kcuzner/rt-soldering-iron/ref/oled-drawing.png

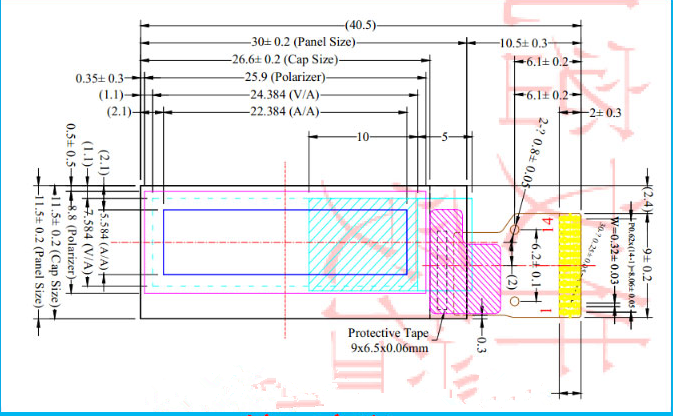
ref/oled-drawing.png
