kcuzner/rt-soldering-iron/ref/oled-pinout.png

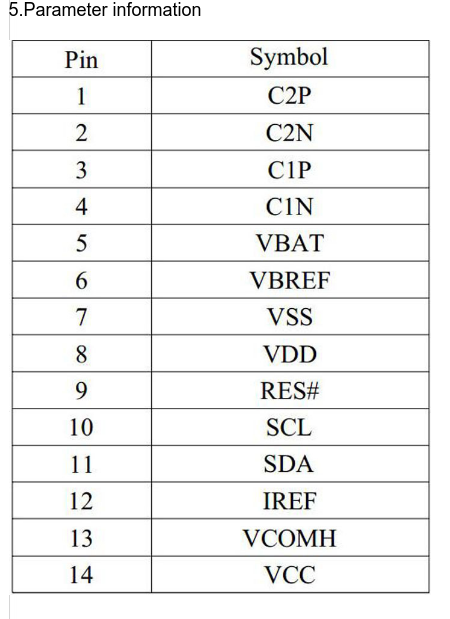
ref/oled-pinout.png
