kcuzner/rt-soldering-iron/ltspice/OVP Latch.asc

C1: cap; 1p
M1: nmos; 2N7002
Q1: pnp; 2N3906
R1: res; 22.6K
R2: res; 10K
R3: res; 10K
R4: res; 1K
R5: res; 10K
R6: res; 10K
U1: TL431
V1: voltage; PULSE(0 3.65 3m 1m 1n 10m 20m)
V2: voltage; PULSE(0 12 0 {DLY})
V3: voltage; 12
Named nets: 0, VLatch
.tran 40m
.step param DLY 0 1m 0.1m
