kcuzner/rt-soldering-iron/kicad/rt-soldering-iron.kicad_pcb

## KiCad design kicad/rt-soldering-iron.kicad_pcb (2017-11-07)

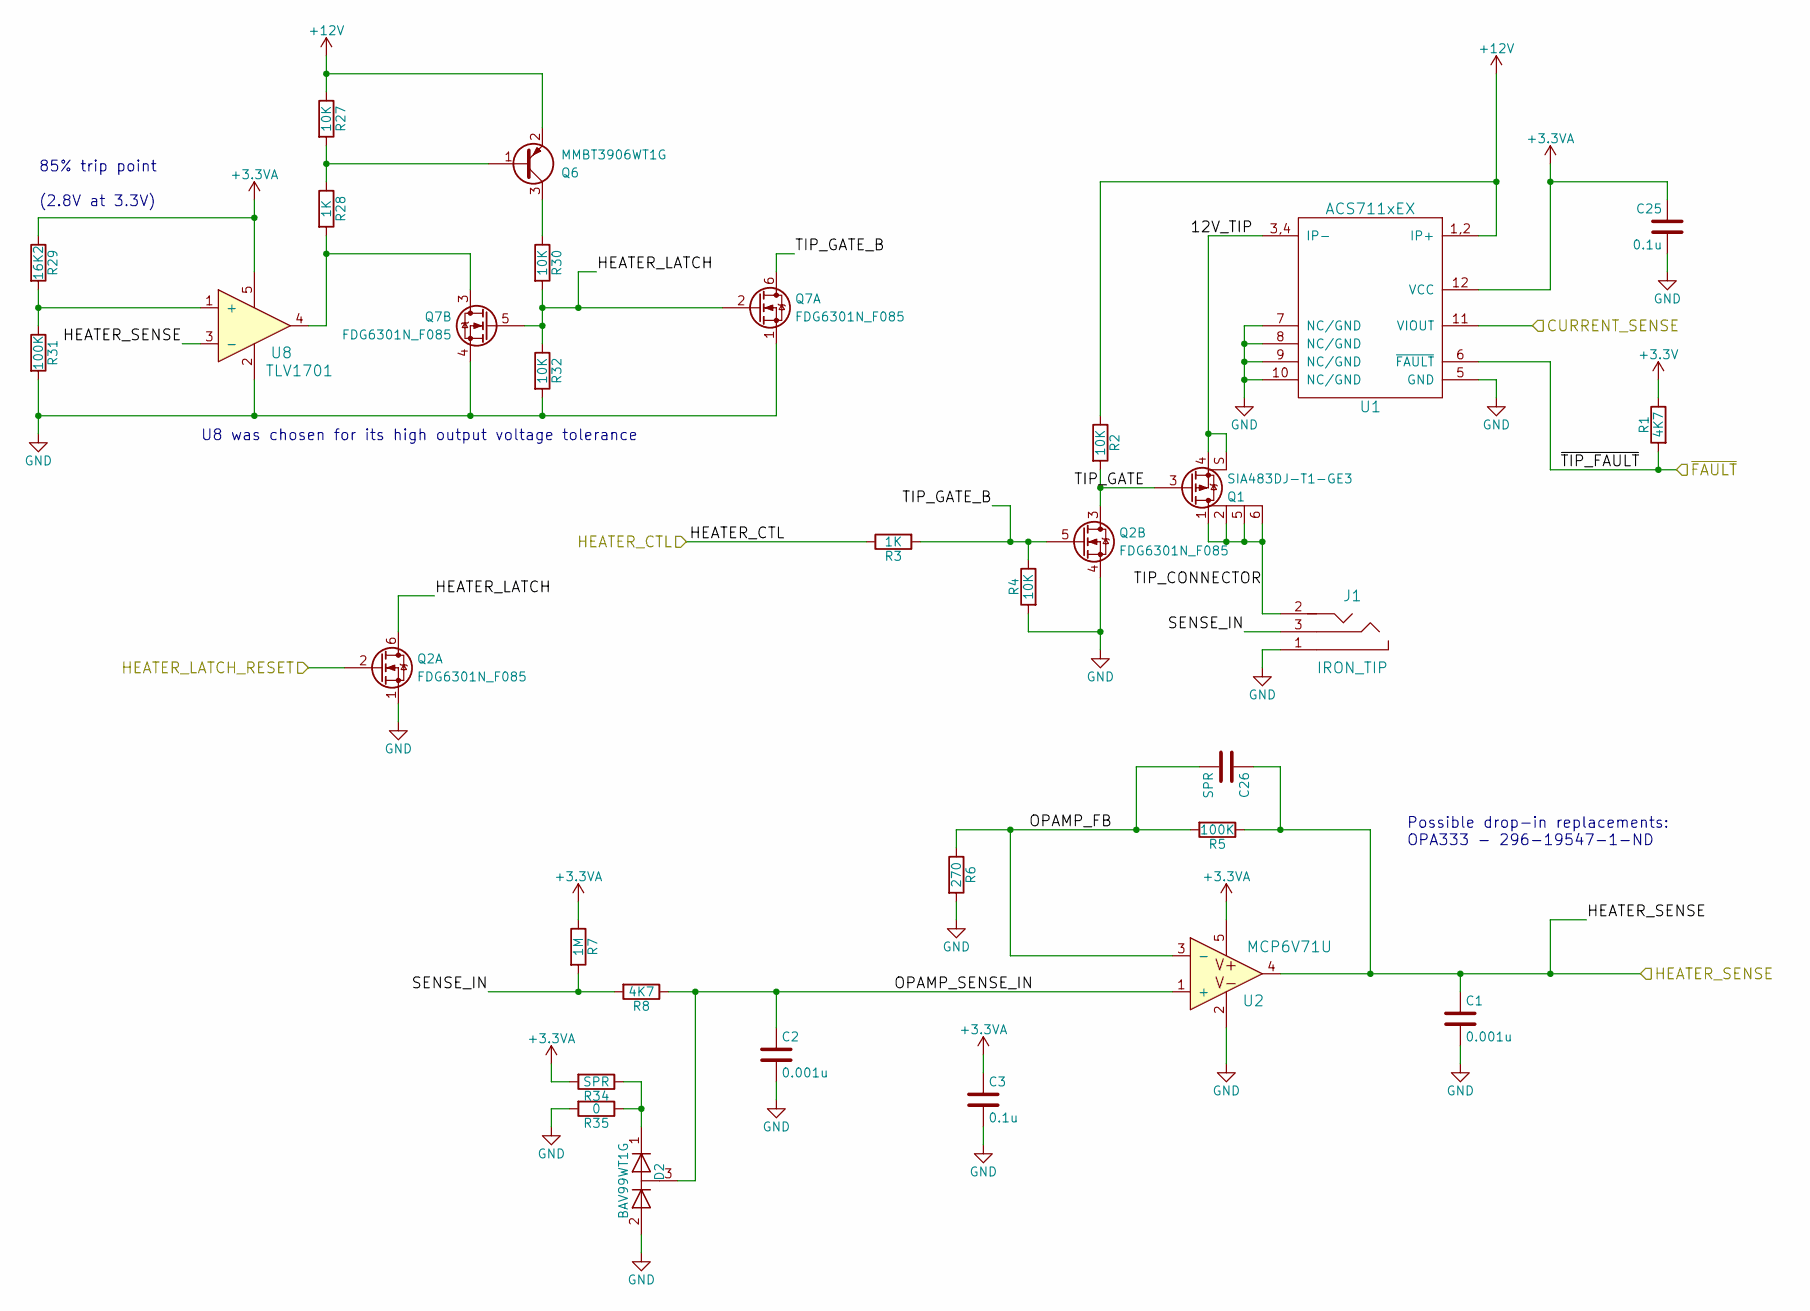
[picture p3: schematic analog-frontend.sch, RT Soldering Iron]

Parts:
C1, C2: 0.001u; C_0402; Part No. 1276-1057-1-ND
C3, C25: 0.1u; C_0402; Part No. 490-14603-1-ND
C26: SPR; C_0402
D2: BAV99WT1G; SOT-323_SC-70; Part No. BAV99WT1GOSCT-ND
J1: IRON_TIP; SJ-3502-SMT; Part No. CP-3502SJCT-ND
Q1: SIA483DJ-T1-GE3; PP-SC70-6L; Part No. SIA483DJ-T1-GE3CT-ND
Q2, Q7: FDG6301N_F085; SOT-363_SC-70-6; Part No. FDG6301N-F085CT-ND
Q6: MMBT3906WT1G; SOT-323_SC-70; Part No. MMBT3906WT1GOSCT-ND
R1, R8: 4K7; R_0402; Part No. 311-4.7KLRCT-ND
R2, R4, R27, R30, R32: 10K; R_0402; Part No. 311-10.0KLRCT-ND
R3, R28: 1K; R_0402; Part No. 311-1.0KJRCT-ND
R5, R31: 100K; R_0402; Part No. RR05P100KDCT-ND
R6: 270; R_0402; Part No. RR05P270DCT-ND
R7: 1M; R_0402; Part No. 311-1.00MLRCT-ND
R29: 16K2; R_0402; Part No. 311-2144-1-ND
R34: SPR; R_0402
R35: 0; R_0402; Part No. 311-0.0JRCT-ND
U1: ACS711xEX; 12-WFQFN; Part No. 620-1483-1-ND
U2: MCP6V71U; SOT-353_SC-70-5; Part No. MCP6V71UT-E/LTYCT-ND
U8: TLV1701; SOT-353_SC-70-5; Part No. 296-40599-1-ND

Connections:
+3.3VA: C3.1, C25.1, R7.1, R29.1, R34.2, U1.12 (VCC), U2.5, U8.5; also elsewhere on the board
+3V3: R1.1; also elsewhere on the board
+12V: Q6.2 (E), R2.1, R27.1, U1.1,2 (IP+); also elsewhere on the board
/Analog Frontend/12V_TIP: Q1.4 (S), Q1.S, U1.3,4 (IP-)
/Analog Frontend/CURRENT_SENSE: U1.11 (VIOUT); also elsewhere on the board
/Analog Frontend/HEATER_CTL: R3.1; also elsewhere on the board
/Analog Frontend/HEATER_LATCH: Q2.6 (D), Q7.2 (G), Q7.5 (G), R30.2, R32.1
/Analog Frontend/HEATER_LATCH_RESET: Q2.2 (G); also elsewhere on the board
/Analog Frontend/HEATER_SENSE: C1.1, C26.1, R5.1, U2.4, U8.3 (-); also elsewhere on the board
/Analog Frontend/OPAMP_FB: C26.2, R5.2, R6.1, U2.3 (-)
/Analog Frontend/OPAMP_SENSE_IN: C2.1, D2.3 (common), R8.1, U2.1 (+)
/Analog Frontend/SENSE_IN: J1.3, R7.2, R8.2
/Analog Frontend/TIP_CONNECTOR: J1.2, Q1.1 (D), Q1.2 (D), Q1.5 (D), Q1.6 (D)
/Analog Frontend/TIP_GATE: Q1.3 (G), Q2.3 (D), R2.2
/Analog Frontend/TIP_GATE_B: Q2.5 (G), Q7.6 (D), R3.2, R4.1
/Analog Frontend/~FAULT: R1.2, U1.6 (~FAULT); also elsewhere on the board
GND: C1.2, C2.2, C3.2, C25.2, D2.2 (A), J1.1, Q2.1 (S), Q2.4 (S), Q7.1 (S), Q7.4 (S), R4.2, R6.2, R31.2, R32.2, R35.2, U1.5 (GND), U1.7 (NC/GND), U1.8 (NC/GND), U1.9 (NC/GND), U1.10 (NC/GND), U2.2, U8.2; also elsewhere on the board
unnamed: D2.1 (K), R34.1, R35.1
unnamed: Q6.1 (B), R27.2, R28.1
unnamed: Q6.3 (C), R30.1
unnamed: Q7.3 (D), R28.2, U8.4
unnamed: R29.2, R31.1, U8.1 (+)

Notes on the sheet:
Possible drop-in replacements: OPA333 - 296-19547-1-ND
85% trip point (2.8V at 3.3V)
U8 was chosen for its high output voltage tolerance

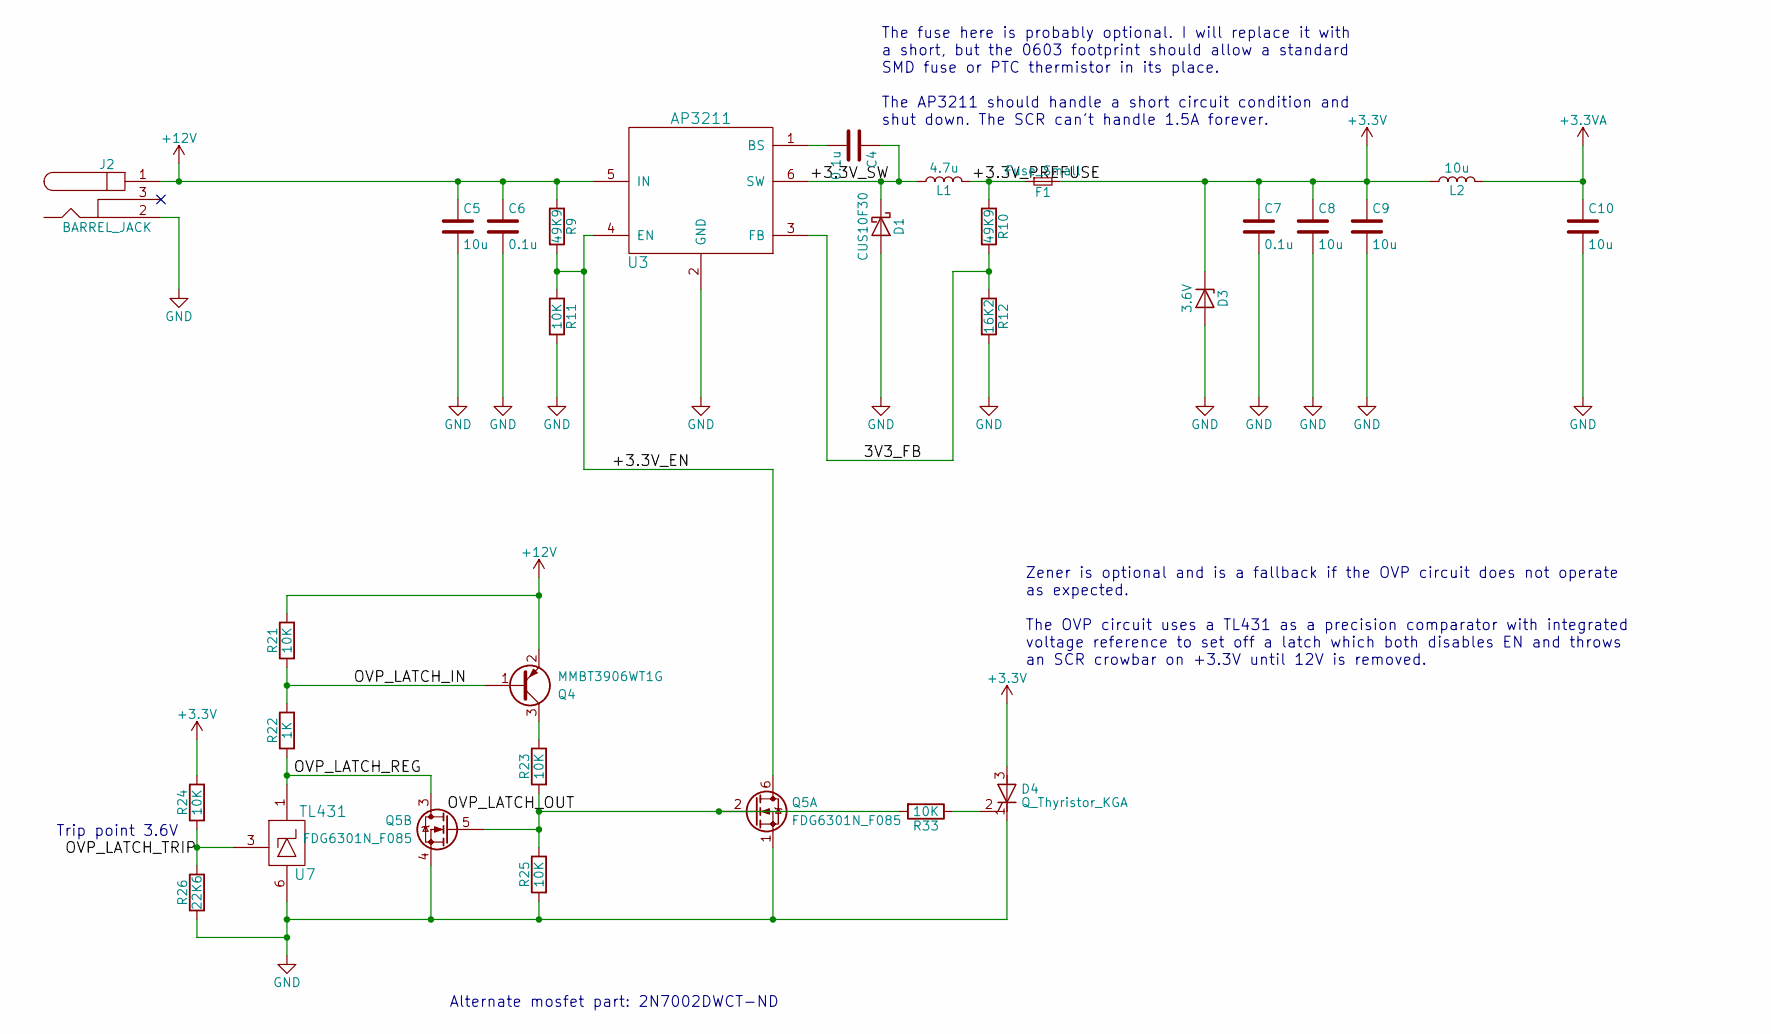
[picture p4: schematic power-supplies.sch, RT Soldering Iron]

Parts:
C4, C6, C7: 0.1u; C_0402; Part No. 490-14603-1-ND
C5: 10u; C_0603; Part No. 490-7202-1-ND
C8, C9, C10: 10u; C_0402; Part No. 1276-6830-1-ND
D1: CUS10F30; D_SOD-323; Part No. CUS10F30H3FCT-ND
D3: 3.6V; D_SOD-523; Part No. DZ2S036M0LCT-ND
D4: Q_Thyristor_KGA; SOT-23; Part No. NYC0102BLT1GOSCT-ND
F1: Fuse_Small; R_0603
J2: BARREL_JACK; PJ-069B-SMT; Part No. CP-069BPJCT-ND
L1: 4.7u; Inductor_Taiyo-Yuden_NR-30xx; Part No. 587-2591-1-ND
L2: 10u; R_0805; Part No. 445-6396-1-ND
Q4: MMBT3906WT1G; SOT-323_SC-70; Part No. MMBT3906WT1GOSCT-ND
Q5: FDG6301N_F085; SOT-363_SC-70-6; Part No. FDG6301N-F085CT-ND
R9, R10: 49K9; R_0402; Part No. 311-2296-1-ND
R11, R21, R23, R24, R25, R33: 10K; R_0402; Part No. 311-10.0KLRCT-ND
R12: 16K2; R_0402; Part No. 311-2144-1-ND
R22: 1K; R_0402; Part No. 311-1.0KJRCT-ND
R26: 22K6; R_0402; Part No. YAG3061CT-ND
U3: AP3211; SOT-23-6; Part No. AP3211KTR-G1DICT-ND
U7: TL431; SOT-363_SC-70-6; Part No. 296-17863-1-ND

Connections:
+3.3VA: C10.1, L2.2; also elsewhere on the board
+3V3: C7.1, C8.1, C9.1, D3.1 (K), D4.3 (A), F1.2, L2.1, R24.1; also elsewhere on the board
+12V: C5.1, C6.1, J2.1, Q4.2 (E), R9.1, R21.1, U3.5 (IN); also elsewhere on the board
/Power Supplies/3V3_FB: R10.2, R12.1, U3.3 (FB)
/Power Supplies/+3.3V_EN: Q5.6 (D), R9.2, R11.1, U3.4 (EN)
/Power Supplies/+3.3V_PREFUSE: F1.1, L1.2, R10.1
/Power Supplies/+3.3V_SW: C4.1, D1.1 (K), L1.1, U3.6 (SW)
/Power Supplies/OVP_LATCH_IN: Q4.1 (B), R21.2, R22.1
/Power Supplies/OVP_LATCH_OUT: Q5.2 (G), Q5.5 (G), R23.2, R25.1, R33.2
/Power Supplies/OVP_LATCH_REG: Q5.3 (D), R22.2, U7.1
/Power Supplies/OVP_LATCH_TRIP: R24.2, R26.1, U7.3
GND: C5.2, C6.2, C7.2, C8.2, C9.2, C10.2, D1.2 (A), D3.2 (A), D4.1 (K), J2.2, Q5.1 (S), Q5.4 (S), R11.2, R12.2, R25.2, R26.2, U3.2 (GND), U7.6; also elsewhere on the board
unnamed: C4.2, U3.1 (BS)
unnamed: D4.2 (G), R33.1
unnamed: Q4.3 (C), R23.1

Notes on the sheet:
Trip point 3.6V
Zener is optional and is a fallback if the OVP circuit does not operate as expected. The OVP circuit uses a TL431 as a precision comparator with integrated voltage reference to set off a latch which both disables EN and throws an SCR crowbar on +3.3V until 12V is removed.
Alternate mosfet part: 2N7002DWCT-ND
The fuse here is probably optional. I will replace it with a short, but the 0603 footprint should allow a standard SMD fuse or PTC thermistor in its place. The AP3211 should handle a short circuit condition and shut down. The SCR can't handle 1.5A forever.

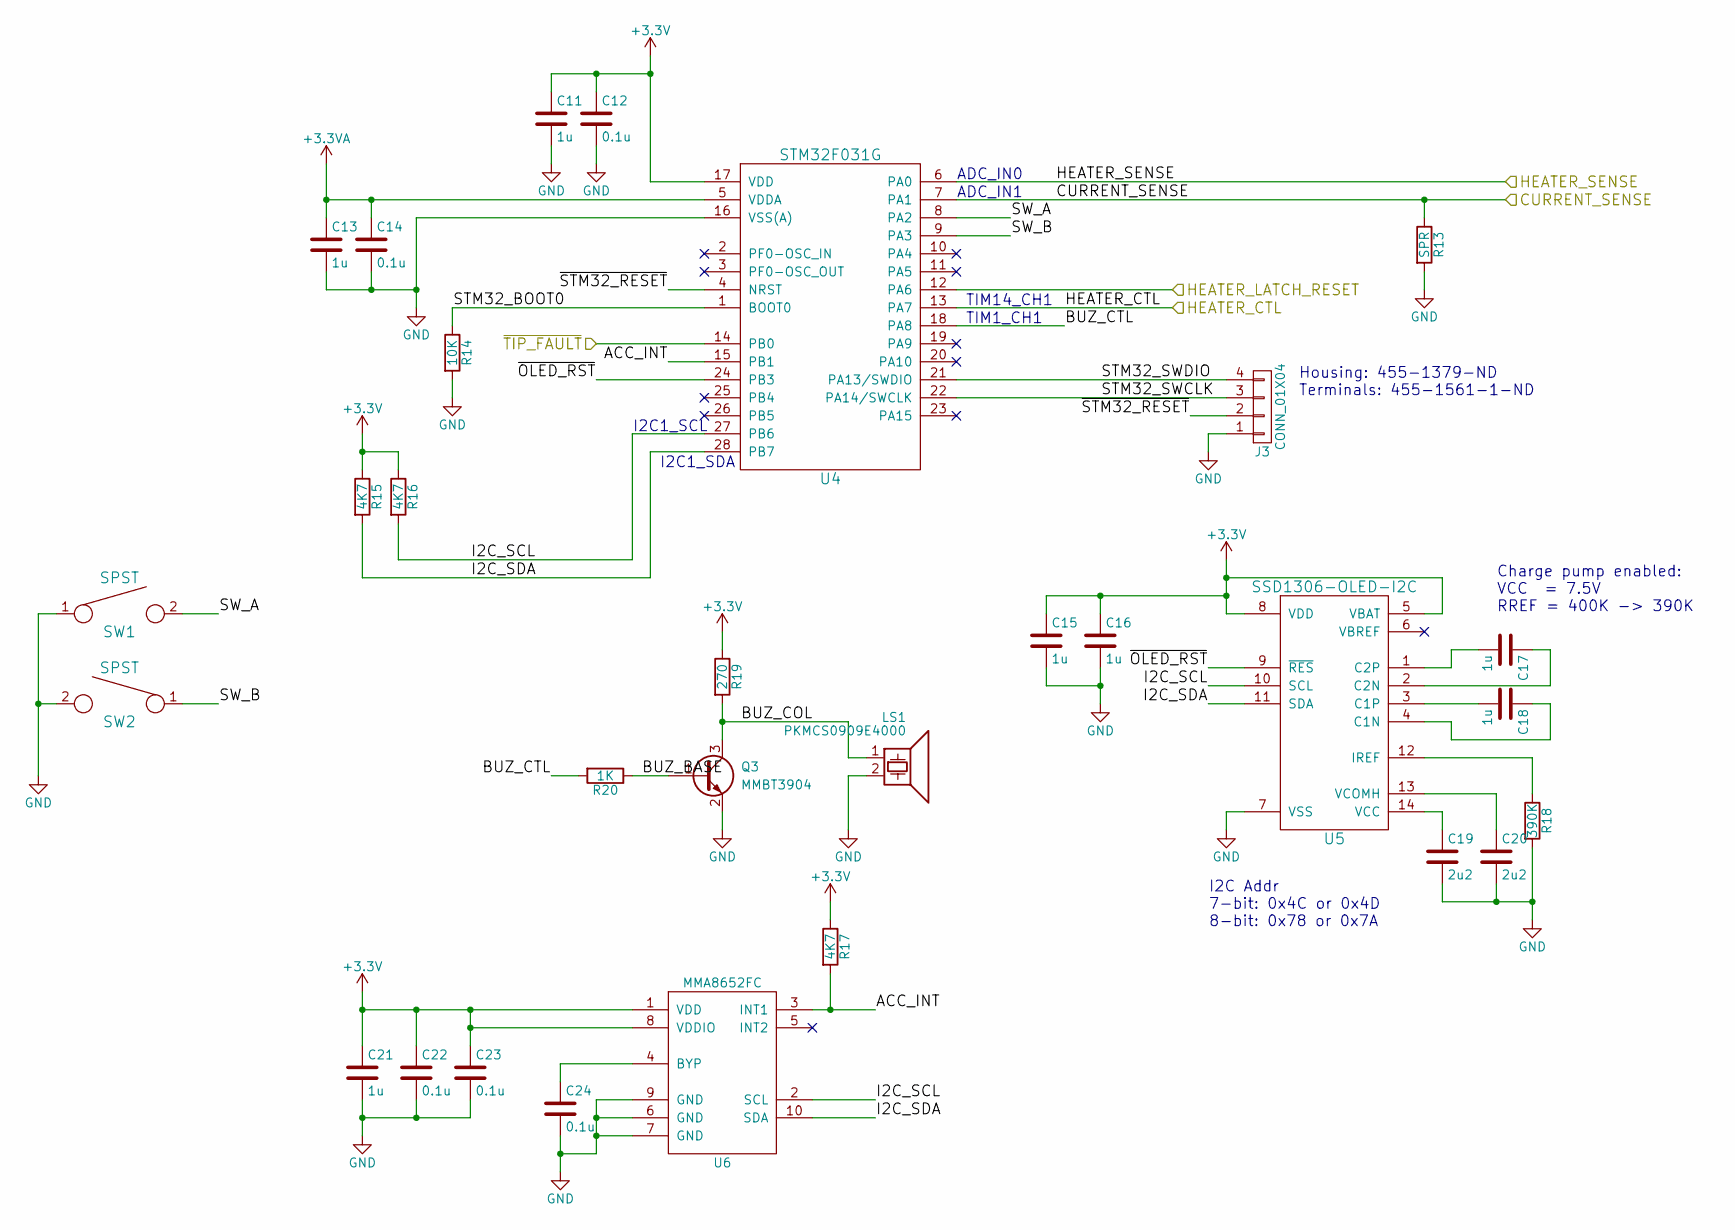
[picture p5: schematic digital-control.sch, RT Soldering Iron]

Parts:
C11, C13, C15, C16, C17, C18, C21: 1u; C_0402; Part No. 490-10018-1-ND
C12, C14, C22, C23, C24: 0.1u; C_0402; Part No. 490-14603-1-ND
C19, C20: 2u2; C_0402; Part No. 490-13234-1-ND
J3: CONN_01X04; JST-SH-4; Part No. 455-1790-1-ND
LS1: PKMCS0909E4000; Murata-PKMCS; Part No. 490-9647-1-ND
Q3: MMBT3904; SOT-323_SC-70; Part No. MMBT3904WT1GOSCT-ND
R13: SPR; R_0402
R14: 10K; R_0402; Part No. 311-10.0KLRCT-ND
R15, R16, R17: 4K7; R_0402; Part No. 311-4.7KLRCT-ND
R18: 390K; R_0402; Part No. 311-390KJRCT-ND
R19: 270; R_0402; Part No. RR05P270DCT-ND
R20: 1K; R_0402; Part No. 311-1.0KJRCT-ND
SW1, SW2: SPST; Panasonic_EVQP4; Part No. P15502CT-ND
U4: STM32F031G; 28-UFQFPN; Part No. 497-13619-ND
U5: SSD1306-OLED-I2C; OLED-FPC-I2C
U6: MMA8652FC; 10-DFN; Part No. MMA8652FCR1CT-ND

Connections:
+3.3VA: C13.1, C14.1, U4.5 (VDDA); also elsewhere on the board
+3V3: C11.1, C12.1, C15.1, C16.1, C21.1, C22.1, C23.1, R15.1, R16.1, R17.1, R19.1, U4.17 (VDD), U5.5 (VBAT), U5.8 (VDD), U6.1 (VDD), U6.8 (VDDIO); also elsewhere on the board
/Analog Frontend/CURRENT_SENSE: R13.1, U4.7 (PA1); also elsewhere on the board
/Analog Frontend/HEATER_CTL: U4.13 (PA7); also elsewhere on the board
/Analog Frontend/HEATER_LATCH_RESET: U4.12 (PA6); also elsewhere on the board
/Analog Frontend/HEATER_SENSE: U4.6 (PA0); also elsewhere on the board
/Analog Frontend/~FAULT: U4.14 (PB0); also elsewhere on the board
/Digital Control/ACC_INT: R17.2, U4.15 (PB1), U6.3 (INT1)
/Digital Control/BUZ_BASE: Q3.1 (B), R20.1
/Digital Control/BUZ_COL: LS1.1, Q3.3 (C), R19.2
/Digital Control/BUZ_CTL: R20.2, U4.18 (PA8)
/Digital Control/I2C_SCL: R16.2, U4.27 (PB6), U5.10 (SCL), U6.2 (SCL)
/Digital Control/I2C_SDA: R15.2, U4.28 (PB7), U5.11 (SDA), U6.10 (SDA)
/Digital Control/STM32_BOOT0: R14.1, U4.1 (BOOT0)
/Digital Control/STM32_SWCLK: J3.3, U4.22 (PA14/SWCLK)
/Digital Control/STM32_SWDIO: J3.4, U4.21 (PA13/SWDIO)
/Digital Control/SW_A: SW1.2, U4.8 (PA2)
/Digital Control/SW_B: SW2.1, U4.9 (PA3)
/Digital Control/~OLED_RST: U4.24 (PB3), U5.9 (~RES)
/Digital Control/~STM32_RESET: J3.2, U4.4 (NRST)
GND: C11.2, C12.2, C13.2, C14.2, C15.2, C16.2, C19.2, C20.2, C21.2, C22.2, C23.2, C24.2, J3.1, J3.NC, LS1.2, Q3.2 (E), R13.2, R14.2, R18.2, SW1.1, SW2.2, U4.16 (VSS(A)), U5.7 (VSS), U6.6 (GND), U6.7 (GND), U6.9 (GND); also elsewhere on the board
unnamed: C17.1, U5.2 (C2N)
unnamed: C17.2, U5.1 (C2P)
unnamed: C18.1, U5.4 (C1N)
unnamed: C18.2, U5.3 (C1P)
unnamed: C19.1, U5.14 (VCC)
unnamed: C20.1, U5.13 (VCOMH)
unnamed: C24.1, U6.4 (BYP)
unnamed: R18.1, U5.12 (IREF)

Notes on the sheet:
I2C Addr 7-bit: 0x4C or 0x4D 8-bit: 0x78 or 0x7A
Housing: 455-1379-ND Terminals: 455-1561-1-ND
ADC_IN0
TIM14_CH1
I2C1_SCL
I2C1_SDA
Charge pump enabled: VCC = 7.5V RREF = 400K -> 390K
ADC_IN1
TIM1_CH1

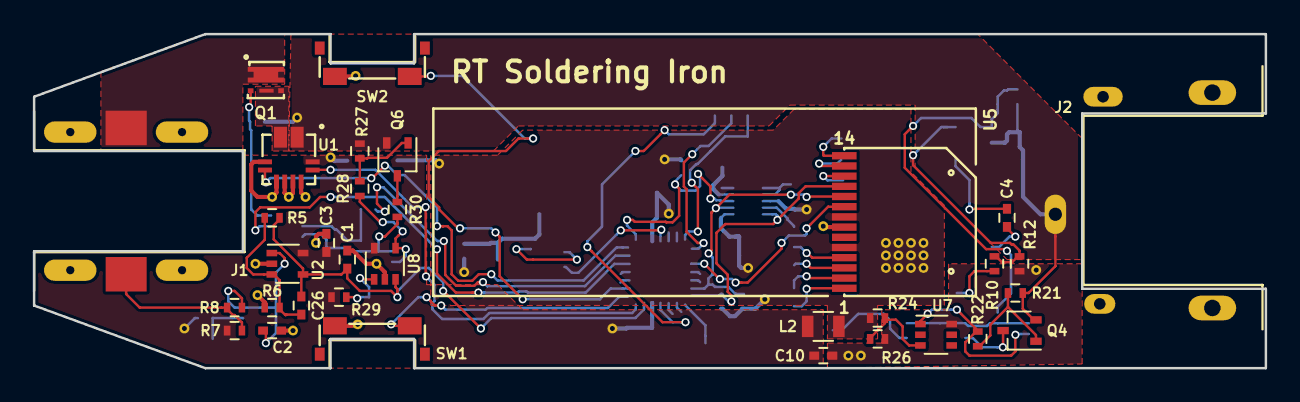
[picture p6: board rt-soldering-iron.kicad_pcb from above]

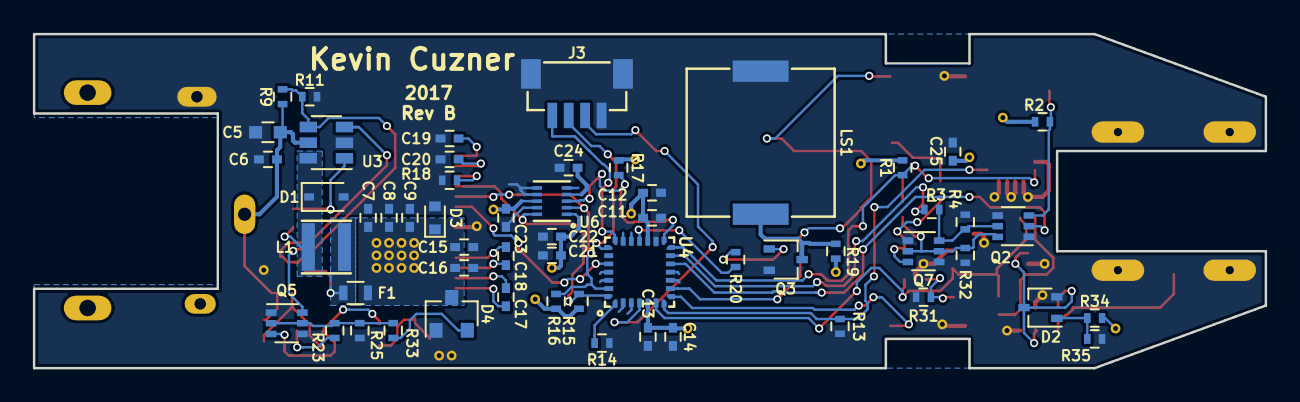
[picture p7: board rt-soldering-iron.kicad_pcb from below]

Board: 2 copper layers, 74.9 x 20.3 mm, 89 parts (56 on the bottom side), 54 nets.
