kcuzner/rt-soldering-iron/rust/components/stm32f031x/src/dbgmcu/apblfz/mod.rs

#[doc = r" Value read from the register"]
pub struct R {
    bits: u32,
}
#[doc = r" Value to write to the register"]
pub struct W {
    bits: u32,
}
impl super::APBLFZ {
    #[doc = r" Modifies the contents of the register"]
    #[inline]
    pub fn modify<F>(&self, f: F)
    where
        for<'w> F: FnOnce(&R, &'w mut W) -> &'w mut W,
    {
        let bits = self.register.get();
        let r = R { bits: bits };
        let mut w = W { bits: bits };
        f(&r, &mut w);
        self.register.set(w.bits);
    }
    #[doc = r" Reads the contents of the register"]
    #[inline]
    pub fn read(&self) -> R {
        R { bits: self.register.get() }
    }
    #[doc = r" Writes to the register"]
    #[inline]
    pub fn write<F>(&self, f: F)
    where
        F: FnOnce(&mut W) -> &mut W,
    {
        let mut w = W::reset_value();
        f(&mut w);
        self.register.set(w.bits);
    }
    #[doc = r" Writes the reset value to the register"]
    #[inline]
    pub fn reset(&self) {
        self.write(|w| w)
    }
}
#[doc = r" Value of the field"]
pub struct DBG_TIMER2_STOPR {
    bits: bool,
}
impl DBG_TIMER2_STOPR {
    #[doc = r" Value of the field as raw bits"]
    #[inline]
    pub fn bit(&self) -> bool {
        self.bits
    }
    #[doc = r" Returns `true` if the bit is clear (0)"]
    #[inline]
    pub fn bit_is_clear(&self) -> bool {
        !self.bit()
    }
    #[doc = r" Returns `true` if the bit is set (1)"]
    #[inline]
    pub fn bit_is_set(&self) -> bool {
        self.bit()
    }
}
#[doc = r" Value of the field"]
pub struct DBG_TIMER3_STOPR {
    bits: bool,
}
impl DBG_TIMER3_STOPR {
    #[doc = r" Value of the field as raw bits"]
    #[inline]
    pub fn bit(&self) -> bool {
        self.bits
    }
    #[doc = r" Returns `true` if the bit is clear (0)"]
    #[inline]
    pub fn bit_is_clear(&self) -> bool {
        !self.bit()
    }
    #[doc = r" Returns `true` if the bit is set (1)"]
    #[inline]
    pub fn bit_is_set(&self) -> bool {
        self.bit()
    }
}
#[doc = r" Value of the field"]
pub struct DBG_TIMER6_STOPR {
    bits: bool,
}
impl DBG_TIMER6_STOPR {
    #[doc = r" Value of the field as raw bits"]
    #[inline]
    pub fn bit(&self) -> bool {
        self.bits
    }
    #[doc = r" Returns `true` if the bit is clear (0)"]
    #[inline]
    pub fn bit_is_clear(&self) -> bool {
        !self.bit()
    }
    #[doc = r" Returns `true` if the bit is set (1)"]
    #[inline]
    pub fn bit_is_set(&self) -> bool {
        self.bit()
    }
}
#[doc = r" Value of the field"]
pub struct DBG_TIMER14_STOPR {
    bits: bool,
}
impl DBG_TIMER14_STOPR {
    #[doc = r" Value of the field as raw bits"]
    #[inline]
    pub fn bit(&self) -> bool {
        self.bits
    }
    #[doc = r" Returns `true` if the bit is clear (0)"]
    #[inline]
    pub fn bit_is_clear(&self) -> bool {
        !self.bit()
    }
    #[doc = r" Returns `true` if the bit is set (1)"]
    #[inline]
    pub fn bit_is_set(&self) -> bool {
        self.bit()
    }
}
#[doc = r" Value of the field"]
pub struct DBG_RTC_STOPR {
    bits: bool,
}
impl DBG_RTC_STOPR {
    #[doc = r" Value of the field as raw bits"]
    #[inline]
    pub fn bit(&self) -> bool {
        self.bits
    }
    #[doc = r" Returns `true` if the bit is clear (0)"]
    #[inline]
    pub fn bit_is_clear(&self) -> bool {
        !self.bit()
    }
    #[doc = r" Returns `true` if the bit is set (1)"]
    #[inline]
    pub fn bit_is_set(&self) -> bool {
        self.bit()
    }
}
#[doc = r" Value of the field"]
pub struct DBG_WWDG_STOPR {
    bits: bool,
}
impl DBG_WWDG_STOPR {
    #[doc = r" Value of the field as raw bits"]
    #[inline]
    pub fn bit(&self) -> bool {
        self.bits
    }
    #[doc = r" Returns `true` if the bit is clear (0)"]
    #[inline]
    pub fn bit_is_clear(&self) -> bool {
        !self.bit()
    }
    #[doc = r" Returns `true` if the bit is set (1)"]
    #[inline]
    pub fn bit_is_set(&self) -> bool {
        self.bit()
    }
}
#[doc = r" Value of the field"]
pub struct DBG_IWDG_STOPR {
    bits: bool,
}
impl DBG_IWDG_STOPR {
    #[doc = r" Value of the field as raw bits"]
    #[inline]
    pub fn bit(&self) -> bool {
        self.bits
    }
    #[doc = r" Returns `true` if the bit is clear (0)"]
    #[inline]
    pub fn bit_is_clear(&self) -> bool {
        !self.bit()
    }
    #[doc = r" Returns `true` if the bit is set (1)"]
    #[inline]
    pub fn bit_is_set(&self) -> bool {
        self.bit()
    }
}
#[doc = r" Value of the field"]
pub struct I2C1_SMBUS_TIMEOUTR {
    bits: bool,
}
impl I2C1_SMBUS_TIMEOUTR {
    #[doc = r" Value of the field as raw bits"]
    #[inline]
    pub fn bit(&self) -> bool {
        self.bits
    }
    #[doc = r" Returns `true` if the bit is clear (0)"]
    #[inline]
    pub fn bit_is_clear(&self) -> bool {
        !self.bit()
    }
    #[doc = r" Returns `true` if the bit is set (1)"]
    #[inline]
    pub fn bit_is_set(&self) -> bool {
        self.bit()
    }
}
#[doc = r" Proxy"]
pub struct _DBG_TIMER2_STOPW<'a> {
    w: &'a mut W,
}
impl<'a> _DBG_TIMER2_STOPW<'a> {
    #[doc = r" Sets the field bit"]
    pub fn set_bit(self) -> &'a mut W {
        self.bit(true)
    }
    #[doc = r" Clears the field bit"]
    pub fn clear_bit(self) -> &'a mut W {
        self.bit(false)
    }
    #[doc = r" Writes raw bits to the field"]
    #[inline]
    pub fn bit(self, value: bool) -> &'a mut W {
        const MASK: bool = true;
        const OFFSET: u8 = 0;
        self.w.bits &= !((MASK as u32) << OFFSET);
        self.w.bits |= ((value & MASK) as u32) << OFFSET;
        self.w
    }
}
#[doc = r" Proxy"]
pub struct _DBG_TIMER3_STOPW<'a> {
    w: &'a mut W,
}
impl<'a> _DBG_TIMER3_STOPW<'a> {
    #[doc = r" Sets the field bit"]
    pub fn set_bit(self) -> &'a mut W {
        self.bit(true)
    }
    #[doc = r" Clears the field bit"]
    pub fn clear_bit(self) -> &'a mut W {
        self.bit(false)
    }
    #[doc = r" Writes raw bits to the field"]
    #[inline]
    pub fn bit(self, value: bool) -> &'a mut W {
        const MASK: bool = true;
        const OFFSET: u8 = 1;
        self.w.bits &= !((MASK as u32) << OFFSET);
        self.w.bits |= ((value & MASK) as u32) << OFFSET;
        self.w
    }
}
#[doc = r" Proxy"]
pub struct _DBG_TIMER6_STOPW<'a> {
    w: &'a mut W,
}
impl<'a> _DBG_TIMER6_STOPW<'a> {
    #[doc = r" Sets the field bit"]
    pub fn set_bit(self) -> &'a mut W {
        self.bit(true)
    }
    #[doc = r" Clears the field bit"]
    pub fn clear_bit(self) -> &'a mut W {
        self.bit(false)
    }
    #[doc = r" Writes raw bits to the field"]
    #[inline]
    pub fn bit(self, value: bool) -> &'a mut W {
        const MASK: bool = true;
        const OFFSET: u8 = 4;
        self.w.bits &= !((MASK as u32) << OFFSET);
        self.w.bits |= ((value & MASK) as u32) << OFFSET;
        self.w
    }
}
#[doc = r" Proxy"]
pub struct _DBG_TIMER14_STOPW<'a> {
    w: &'a mut W,
}
impl<'a> _DBG_TIMER14_STOPW<'a> {
    #[doc = r" Sets the field bit"]
    pub fn set_bit(self) -> &'a mut W {
        self.bit(true)
    }
    #[doc = r" Clears the field bit"]
    pub fn clear_bit(self) -> &'a mut W {
        self.bit(false)
    }
    #[doc = r" Writes raw bits to the field"]
    #[inline]
    pub fn bit(self, value: bool) -> &'a mut W {
        const MASK: bool = true;
        const OFFSET: u8 = 8;
        self.w.bits &= !((MASK as u32) << OFFSET);
        self.w.bits |= ((value & MASK) as u32) << OFFSET;
        self.w
    }
}
#[doc = r" Proxy"]
pub struct _DBG_RTC_STOPW<'a> {
    w: &'a mut W,
}
impl<'a> _DBG_RTC_STOPW<'a> {
    #[doc = r" Sets the field bit"]
    pub fn set_bit(self) -> &'a mut W {
        self.bit(true)
    }
    #[doc = r" Clears the field bit"]
    pub fn clear_bit(self) -> &'a mut W {
        self.bit(false)
    }
    #[doc = r" Writes raw bits to the field"]
    #[inline]
    pub fn bit(self, value: bool) -> &'a mut W {
        const MASK: bool = true;
        const OFFSET: u8 = 10;
        self.w.bits &= !((MASK as u32) << OFFSET);
        self.w.bits |= ((value & MASK) as u32) << OFFSET;
        self.w
    }
}
#[doc = r" Proxy"]
pub struct _DBG_WWDG_STOPW<'a> {
    w: &'a mut W,
}
impl<'a> _DBG_WWDG_STOPW<'a> {
    #[doc = r" Sets the field bit"]
    pub fn set_bit(self) -> &'a mut W {
        self.bit(true)
    }
    #[doc = r" Clears the field bit"]
    pub fn clear_bit(self) -> &'a mut W {
        self.bit(false)
    }
    #[doc = r" Writes raw bits to the field"]
    #[inline]
    pub fn bit(self, value: bool) -> &'a mut W {
        const MASK: bool = true;
        const OFFSET: u8 = 11;
        self.w.bits &= !((MASK as u32) << OFFSET);
        self.w.bits |= ((value & MASK) as u32) << OFFSET;
        self.w
    }
}
#[doc = r" Proxy"]
pub struct _DBG_IWDG_STOPW<'a> {
    w: &'a mut W,
}
impl<'a> _DBG_IWDG_STOPW<'a> {
    #[doc = r" Sets the field bit"]
    pub fn set_bit(self) -> &'a mut W {
        self.bit(true)
    }
    #[doc = r" Clears the field bit"]
    pub fn clear_bit(self) -> &'a mut W {
        self.bit(false)
    }
    #[doc = r" Writes raw bits to the field"]
    #[inline]
    pub fn bit(self, value: bool) -> &'a mut W {
        const MASK: bool = true;
        const OFFSET: u8 = 12;
        self.w.bits &= !((MASK as u32) << OFFSET);
        self.w.bits |= ((value & MASK) as u32) << OFFSET;
        self.w
    }
}
#[doc = r" Proxy"]
pub struct _I2C1_SMBUS_TIMEOUTW<'a> {
    w: &'a mut W,
}
impl<'a> _I2C1_SMBUS_TIMEOUTW<'a> {
    #[doc = r" Sets the field bit"]
    pub fn set_bit(self) -> &'a mut W {
        self.bit(true)
    }
    #[doc = r" Clears the field bit"]
    pub fn clear_bit(self) -> &'a mut W {
        self.bit(false)
    }
    #[doc = r" Writes raw bits to the field"]
    #[inline]
    pub fn bit(self, value: bool) -> &'a mut W {
        const MASK: bool = true;
        const OFFSET: u8 = 21;
        self.w.bits &= !((MASK as u32) << OFFSET);
        self.w.bits |= ((value & MASK) as u32) << OFFSET;
        self.w
    }
}
impl R {
    #[doc = r" Value of the register as raw bits"]
    #[inline]
    pub fn bits(&self) -> u32 {
        self.bits
    }
    #[doc = "Bit 0 - Debug Timer 2 stopped when Core is halted"]
    #[inline]
    pub fn dbg_timer2_stop(&self) -> DBG_TIMER2_STOPR {
        let bits = {
            const MASK: bool = true;
            const OFFSET: u8 = 0;
            ((self.bits >> OFFSET) & MASK as u32) != 0
        };
        DBG_TIMER2_STOPR { bits }
    }
    #[doc = "Bit 1 - Debug Timer 3 stopped when Core is halted"]
    #[inline]
    pub fn dbg_timer3_stop(&self) -> DBG_TIMER3_STOPR {
        let bits = {
            const MASK: bool = true;
            const OFFSET: u8 = 1;
            ((self.bits >> OFFSET) & MASK as u32) != 0
        };
        DBG_TIMER3_STOPR { bits }
    }
    #[doc = "Bit 4 - Debug Timer 6 stopped when Core is halted"]
    #[inline]
    pub fn dbg_timer6_stop(&self) -> DBG_TIMER6_STOPR {
        let bits = {
            const MASK: bool = true;
            const OFFSET: u8 = 4;
            ((self.bits >> OFFSET) & MASK as u32) != 0
        };
        DBG_TIMER6_STOPR { bits }
    }
    #[doc = "Bit 8 - Debug Timer 14 stopped when Core is halted"]
    #[inline]
    pub fn dbg_timer14_stop(&self) -> DBG_TIMER14_STOPR {
        let bits = {
            const MASK: bool = true;
            const OFFSET: u8 = 8;
            ((self.bits >> OFFSET) & MASK as u32) != 0
        };
        DBG_TIMER14_STOPR { bits }
    }
    #[doc = "Bit 10 - Debug RTC stopped when Core is halted"]
    #[inline]
    pub fn dbg_rtc_stop(&self) -> DBG_RTC_STOPR {
        let bits = {
            const MASK: bool = true;
            const OFFSET: u8 = 10;
            ((self.bits >> OFFSET) & MASK as u32) != 0
        };
        DBG_RTC_STOPR { bits }
    }
    #[doc = "Bit 11 - Debug Window Wachdog stopped when Core is halted"]
    #[inline]
    pub fn dbg_wwdg_stop(&self) -> DBG_WWDG_STOPR {
        let bits = {
            const MASK: bool = true;
            const OFFSET: u8 = 11;
            ((self.bits >> OFFSET) & MASK as u32) != 0
        };
        DBG_WWDG_STOPR { bits }
    }
    #[doc = "Bit 12 - Debug Independent Wachdog stopped when Core is halted"]
    #[inline]
    pub fn dbg_iwdg_stop(&self) -> DBG_IWDG_STOPR {
        let bits = {
            const MASK: bool = true;
            const OFFSET: u8 = 12;
            ((self.bits >> OFFSET) & MASK as u32) != 0
        };
        DBG_IWDG_STOPR { bits }
    }
    #[doc = "Bit 21 - SMBUS timeout mode stopped when Core is halted"]
    #[inline]
    pub fn i2c1_smbus_timeout(&self) -> I2C1_SMBUS_TIMEOUTR {
        let bits = {
            const MASK: bool = true;
            const OFFSET: u8 = 21;
            ((self.bits >> OFFSET) & MASK as u32) != 0
        };
        I2C1_SMBUS_TIMEOUTR { bits }
    }
}
impl W {
    #[doc = r" Reset value of the register"]
    #[inline]
    pub fn reset_value() -> W {
        W { bits: 0 }
    }
    #[doc = r" Writes raw bits to the register"]
    #[inline]
    pub unsafe fn bits(&mut self, bits: u32) -> &mut Self {
        self.bits = bits;
        self
    }
    #[doc = "Bit 0 - Debug Timer 2 stopped when Core is halted"]
    #[inline]
    pub fn dbg_timer2_stop(&mut self) -> _DBG_TIMER2_STOPW {
        _DBG_TIMER2_STOPW { w: self }
    }
    #[doc = "Bit 1 - Debug Timer 3 stopped when Core is halted"]
    #[inline]
    pub fn dbg_timer3_stop(&mut self) -> _DBG_TIMER3_STOPW {
        _DBG_TIMER3_STOPW { w: self }
    }
    #[doc = "Bit 4 - Debug Timer 6 stopped when Core is halted"]
    #[inline]
    pub fn dbg_timer6_stop(&mut self) -> _DBG_TIMER6_STOPW {
        _DBG_TIMER6_STOPW { w: self }
    }
    #[doc = "Bit 8 - Debug Timer 14 stopped when Core is halted"]
    #[inline]
    pub fn dbg_timer14_stop(&mut self) -> _DBG_TIMER14_STOPW {
        _DBG_TIMER14_STOPW { w: self }
    }
    #[doc = "Bit 10 - Debug RTC stopped when Core is halted"]
    #[inline]
    pub fn dbg_rtc_stop(&mut self) -> _DBG_RTC_STOPW {
        _DBG_RTC_STOPW { w: self }
    }
    #[doc = "Bit 11 - Debug Window Wachdog stopped when Core is halted"]
    #[inline]
    pub fn dbg_wwdg_stop(&mut self) -> _DBG_WWDG_STOPW {
        _DBG_WWDG_STOPW { w: self }
    }
    #[doc = "Bit 12 - Debug Independent Wachdog stopped when Core is halted"]
    #[inline]
    pub fn dbg_iwdg_stop(&mut self) -> _DBG_IWDG_STOPW {
        _DBG_IWDG_STOPW { w: self }
    }
    #[doc = "Bit 21 - SMBUS timeout mode stopped when Core is halted"]
    #[inline]
    pub fn i2c1_smbus_timeout(&mut self) -> _I2C1_SMBUS_TIMEOUTW {
        _I2C1_SMBUS_TIMEOUTW { w: self }
    }
}
