kcuzner/rt-soldering-iron/rust/components/stm32f031x/src/gpioa/moder/mod.rs

#[doc = r" Value read from the register"]
pub struct R {
    bits: u32,
}
#[doc = r" Value to write to the register"]
pub struct W {
    bits: u32,
}
impl super::MODER {
    #[doc = r" Modifies the contents of the register"]
    #[inline]
    pub fn modify<F>(&self, f: F)
    where
        for<'w> F: FnOnce(&R, &'w mut W) -> &'w mut W,
    {
        let bits = self.register.get();
        let r = R { bits: bits };
        let mut w = W { bits: bits };
        f(&r, &mut w);
        self.register.set(w.bits);
    }
    #[doc = r" Reads the contents of the register"]
    #[inline]
    pub fn read(&self) -> R {
        R { bits: self.register.get() }
    }
    #[doc = r" Writes to the register"]
    #[inline]
    pub fn write<F>(&self, f: F)
    where
        F: FnOnce(&mut W) -> &mut W,
    {
        let mut w = W::reset_value();
        f(&mut w);
        self.register.set(w.bits);
    }
    #[doc = r" Writes the reset value to the register"]
    #[inline]
    pub fn reset(&self) {
        self.write(|w| w)
    }
}
#[doc = "Possible values of the field `MODER15`"]
pub type MODER15R = ::gpiof::moder::MODER15R;
#[doc = "Possible values of the field `MODER14`"]
pub type MODER14R = ::gpiof::moder::MODER15R;
#[doc = "Possible values of the field `MODER13`"]
pub type MODER13R = ::gpiof::moder::MODER15R;
#[doc = "Possible values of the field `MODER12`"]
pub type MODER12R = ::gpiof::moder::MODER15R;
#[doc = "Possible values of the field `MODER11`"]
pub type MODER11R = ::gpiof::moder::MODER15R;
#[doc = "Possible values of the field `MODER10`"]
pub type MODER10R = ::gpiof::moder::MODER15R;
#[doc = "Possible values of the field `MODER9`"]
pub type MODER9R = ::gpiof::moder::MODER15R;
#[doc = "Possible values of the field `MODER8`"]
pub type MODER8R = ::gpiof::moder::MODER15R;
#[doc = "Possible values of the field `MODER7`"]
pub type MODER7R = ::gpiof::moder::MODER15R;
#[doc = "Possible values of the field `MODER6`"]
pub type MODER6R = ::gpiof::moder::MODER15R;
#[doc = "Possible values of the field `MODER5`"]
pub type MODER5R = ::gpiof::moder::MODER15R;
#[doc = "Possible values of the field `MODER4`"]
pub type MODER4R = ::gpiof::moder::MODER15R;
#[doc = "Possible values of the field `MODER3`"]
pub type MODER3R = ::gpiof::moder::MODER15R;
#[doc = "Possible values of the field `MODER2`"]
pub type MODER2R = ::gpiof::moder::MODER15R;
#[doc = "Possible values of the field `MODER1`"]
pub type MODER1R = ::gpiof::moder::MODER15R;
#[doc = "Possible values of the field `MODER0`"]
pub type MODER0R = ::gpiof::moder::MODER15R;
#[doc = "Values that can be written to the field `MODER15`"]
pub type MODER15W = ::gpiof::moder::MODER15W;
#[doc = r" Proxy"]
pub struct _MODER15W<'a> {
    w: &'a mut W,
}
impl<'a> _MODER15W<'a> {
    #[doc = r" Writes `variant` to the field"]
    #[inline]
    pub fn variant(self, variant: MODER15W) -> &'a mut W {
        {
            self.bits(variant._bits())
        }
    }
    #[doc = "`0`"]
    #[inline]
    pub fn input(self) -> &'a mut W {
        self.variant(::gpiof::moder::MODER15W::INPUT)
    }
    #[doc = "`1`"]
    #[inline]
    pub fn output(self) -> &'a mut W {
        self.variant(::gpiof::moder::MODER15W::OUTPUT)
    }
    #[doc = "`10`"]
    #[inline]
    pub fn alternate(self) -> &'a mut W {
        self.variant(::gpiof::moder::MODER15W::ALTERNATE)
    }
    #[doc = "`11`"]
    #[inline]
    pub fn analog_input(self) -> &'a mut W {
        self.variant(::gpiof::moder::MODER15W::ANALOGINPUT)
    }
    #[doc = r" Writes raw bits to the field"]
    #[inline]
    pub fn bits(self, value: u8) -> &'a mut W {
        const MASK: u8 = 3;
        const OFFSET: u8 = 30;
        self.w.bits &= !((MASK as u32) << OFFSET);
        self.w.bits |= ((value & MASK) as u32) << OFFSET;
        self.w
    }
}
#[doc = "Values that can be written to the field `MODER14`"]
pub type MODER14W = ::gpiof::moder::MODER15W;
#[doc = r" Proxy"]
pub struct _MODER14W<'a> {
    w: &'a mut W,
}
impl<'a> _MODER14W<'a> {
    #[doc = r" Writes `variant` to the field"]
    #[inline]
    pub fn variant(self, variant: MODER14W) -> &'a mut W {
        {
            self.bits(variant._bits())
        }
    }
    #[doc = "`0`"]
    #[inline]
    pub fn input(self) -> &'a mut W {
        self.variant(::gpiof::moder::MODER15W::INPUT)
    }
    #[doc = "`1`"]
    #[inline]
    pub fn output(self) -> &'a mut W {
        self.variant(::gpiof::moder::MODER15W::OUTPUT)
    }
    #[doc = "`10`"]
    #[inline]
    pub fn alternate(self) -> &'a mut W {
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
    }
    #[doc = r" Writes raw bits to the field"]
    #[inline]
    pub fn bits(self, value: u8) -> &'a mut W {
        const MASK: u8 = 3;
        const OFFSET: u8 = 2;
        self.w.bits &= !((MASK as u32) << OFFSET);
        self.w.bits |= ((value & MASK) as u32) << OFFSET;
        self.w
    }
}
#[doc = "Values that can be written to the field `MODER0`"]
pub type MODER0W = ::gpiof::moder::MODER15W;
#[doc = r" Proxy"]
pub struct _MODER0W<'a> {
    w: &'a mut W,
}
impl<'a> _MODER0W<'a> {
    #[doc = r" Writes `variant` to the field"]
    #[inline]
    pub fn variant(self, variant: MODER0W) -> &'a mut W {
        {
            self.bits(variant._bits())
        }
    }
    #[doc = "`0`"]
    #[inline]
    pub fn input(self) -> &'a mut W {
        self.variant(::gpiof::moder::MODER15W::INPUT)
    }
    #[doc = "`1`"]
    #[inline]
    pub fn output(self) -> &'a mut W {
        self.variant(::gpiof::moder::MODER15W::OUTPUT)
    }
    #[doc = "`10`"]
    #[inline]
    pub fn alternate(self) -> &'a mut W {
        self.variant(::gpiof::moder::MODER15W::ALTERNATE)
    }
    #[doc = "`11`"]
    #[inline]
    pub fn analog_input(self) -> &'a mut W {
        self.variant(::gpiof::moder::MODER15W::ANALOGINPUT)
    }
    #[doc = r" Writes raw bits to the field"]
    #[inline]
    pub fn bits(self, value: u8) -> &'a mut W {
        const MASK: u8 = 3;
        const OFFSET: u8 = 0;
        self.w.bits &= !((MASK as u32) << OFFSET);
        self.w.bits |= ((value & MASK) as u32) << OFFSET;
        self.w
    }
}
impl R {
    #[doc = r" Value of the register as raw bits"]
    #[inline]
    pub fn bits(&self) -> u32 {
        self.bits
    }
    #[doc = "Bits 30:31 - Port x configuration bits (y = 0..15)"]
    #[inline]
    pub fn moder15(&self) -> MODER15R {
        MODER15R::_from({
            const MASK: u8 = 3;
            const OFFSET: u8 = 30;
            ((self.bits >> OFFSET) & MASK as u32) as u8
        })
    }
    #[doc = "Bits 28:29 - Port x configuration bits (y = 0..15)"]
    #[inline]
    pub fn moder14(&self) -> MODER14R {
        MODER14R::_from({
            const MASK: u8 = 3;
            const OFFSET: u8 = 28;
            ((self.bits >> OFFSET) & MASK as u32) as u8
        })
    }
    #[doc = "Bits 26:27 - Port x configuration bits (y = 0..15)"]
    #[inline]
    pub fn moder13(&self) -> MODER13R {
        MODER13R::_from({
            const MASK: u8 = 3;
            const OFFSET: u8 = 26;
            ((self.bits >> OFFSET) & MASK as u32) as u8
        })
    }
    #[doc = "Bits 24:25 - Port x configuration bits (y = 0..15)"]
    #[inline]
    pub fn moder12(&self) -> MODER12R {
        MODER12R::_from({
            const MASK: u8 = 3;
            const OFFSET: u8 = 24;
            ((self.bits >> OFFSET) & MASK as u32) as u8
        })
    }
    #[doc = "Bits 22:23 - Port x configuration bits (y = 0..15)"]
    #[inline]
    pub fn moder11(&self) -> MODER11R {
        MODER11R::_from({
            const MASK: u8 = 3;
            const OFFSET: u8 = 22;
            ((self.bits >> OFFSET) & MASK as u32) as u8
        })
    }
    #[doc = "Bits 20:21 - Port x configuration bits (y = 0..15)"]
    #[inline]
    pub fn moder10(&self) -> MODER10R {
        MODER10R::_from({
            const MASK: u8 = 3;
            const OFFSET: u8 = 20;
            ((self.bits >> OFFSET) & MASK as u32) as u8
        })
    }
    #[doc = "Bits 18:19 - Port x configuration bits (y = 0..15)"]
    #[inline]
    pub fn moder9(&self) -> MODER9R {
        MODER9R::_from({
            const MASK: u8 = 3;
            const OFFSET: u8 = 18;
            ((self.bits >> OFFSET) & MASK as u32) as u8
        })
    }
    #[doc = "Bits 16:17 - Port x configuration bits (y = 0..15)"]
    #[inline]
    pub fn moder8(&self) -> MODER8R {
        MODER8R::_from({
            const MASK: u8 = 3;
            const OFFSET: u8 = 16;
            ((self.bits >> OFFSET) & MASK as u32) as u8
        })
    }
    #[doc = "Bits 14:15 - Port x configuration bits (y = 0..15)"]
    #[inline]
    pub fn moder7(&self) -> MODER7R {
        MODER7R::_from({
            const MASK: u8 = 3;
            const OFFSET: u8 = 14;
            ((self.bits >> OFFSET) & MASK as u32) as u8
        })
    }
    #[doc = "Bits 12:13 - Port x configuration bits (y = 0..15)"]
    #[inline]
    pub fn moder6(&self) -> MODER6R {
        MODER6R::_from({
            const MASK: u8 = 3;
            const OFFSET: u8 = 12;
            ((self.bits >> OFFSET) & MASK as u32) as u8
        })
    }
    #[doc = "Bits 10:11 - Port x configuration bits (y = 0..15)"]
    #[inline]
    pub fn moder5(&self) -> MODER5R {
        MODER5R::_from({
            const MASK: u8 = 3;
            const OFFSET: u8 = 10;
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
    #[inline]
    pub fn moder1(&mut self) -> _MODER1W {
        _MODER1W { w: self }
    }
    #[doc = "Bits 0:1 - Port x configuration bits (y = 0..15)"]
    #[inline]
    pub fn moder0(&mut self) -> _MODER0W {
        _MODER0W { w: self }
    }
}
