kcuzner/rt-soldering-iron/rust/components/stm32f031x/src/gpioa/ospeedr/mod.rs

#[doc = r" Value read from the register"]
pub struct R {
    bits: u32,
}
#[doc = r" Value to write to the register"]
pub struct W {
    bits: u32,
}
impl super::OSPEEDR {
    #[doc = r" Modifies the contents of the register"]
    #[inline]
    pub fn modify<F>(&self, f: F)
    where
        for<'w> F: FnOnce(&R, &'w mut W) -> &'w mut W,
    {
        let bits = self.register.get();
        let r = R { bits: bits };
        let mut w = W { bits: bits };
        f(&r, &mut w);
        self.register.set(w.bits);
    }
    #[doc = r" Reads the contents of the register"]
    #[inline]
    pub fn read(&self) -> R {
        R { bits: self.register.get() }
    }
    #[doc = r" Writes to the register"]
    #[inline]
    pub fn write<F>(&self, f: F)
    where
        F: FnOnce(&mut W) -> &mut W,
    {
        let mut w = W::reset_value();
        f(&mut w);
        self.register.set(w.bits);
    }
    #[doc = r" Writes the reset value to the register"]
    #[inline]
    pub fn reset(&self) {
        self.write(|w| w)
    }
}
#[doc = "Possible values of the field `OSPEEDR15`"]
pub type OSPEEDR15R = ::gpiof::ospeedr::OSPEEDR15R;
#[doc = "Possible values of the field `OSPEEDR14`"]
pub type OSPEEDR14R = ::gpiof::ospeedr::OSPEEDR15R;
#[doc = "Possible values of the field `OSPEEDR13`"]
pub type OSPEEDR13R = ::gpiof::ospeedr::OSPEEDR15R;
#[doc = "Possible values of the field `OSPEEDR12`"]
pub type OSPEEDR12R = ::gpiof::ospeedr::OSPEEDR15R;
#[doc = "Possible values of the field `OSPEEDR11`"]
pub type OSPEEDR11R = ::gpiof::ospeedr::OSPEEDR15R;
#[doc = "Possible values of the field `OSPEEDR10`"]
pub type OSPEEDR10R = ::gpiof::ospeedr::OSPEEDR15R;
#[doc = "Possible values of the field `OSPEEDR9`"]
pub type OSPEEDR9R = ::gpiof::ospeedr::OSPEEDR15R;
#[doc = "Possible values of the field `OSPEEDR8`"]
pub type OSPEEDR8R = ::gpiof::ospeedr::OSPEEDR15R;
#[doc = "Possible values of the field `OSPEEDR7`"]
pub type OSPEEDR7R = ::gpiof::ospeedr::OSPEEDR15R;
#[doc = "Possible values of the field `OSPEEDR6`"]
pub type OSPEEDR6R = ::gpiof::ospeedr::OSPEEDR15R;
#[doc = "Possible values of the field `OSPEEDR5`"]
pub type OSPEEDR5R = ::gpiof::ospeedr::OSPEEDR15R;
#[doc = "Possible values of the field `OSPEEDR4`"]
pub type OSPEEDR4R = ::gpiof::ospeedr::OSPEEDR15R;
#[doc = "Possible values of the field `OSPEEDR3`"]
pub type OSPEEDR3R = ::gpiof::ospeedr::OSPEEDR15R;
#[doc = "Possible values of the field `OSPEEDR2`"]
pub type OSPEEDR2R = ::gpiof::ospeedr::OSPEEDR15R;
#[doc = "Possible values of the field `OSPEEDR1`"]
pub type OSPEEDR1R = ::gpiof::ospeedr::OSPEEDR15R;
#[doc = "Possible values of the field `OSPEEDR0`"]
pub type OSPEEDR0R = ::gpiof::ospeedr::OSPEEDR15R;
#[doc = "Values that can be written to the field `OSPEEDR15`"]
pub type OSPEEDR15W = ::gpiof::ospeedr::OSPEEDR15W;
#[doc = r" Proxy"]
pub struct _OSPEEDR15W<'a> {
    w: &'a mut W,
}
impl<'a> _OSPEEDR15W<'a> {
    #[doc = r" Writes `variant` to the field"]
    #[inline]
    pub fn variant(self, variant: OSPEEDR15W) -> &'a mut W {
        unsafe { self.bits(variant._bits()) }
    }
    #[doc = "`0`"]
    #[inline]
    pub fn low(self) -> &'a mut W {
        self.variant(::gpiof::ospeedr::OSPEEDR15W::LOW)
    }
    #[doc = "`1`"]
    #[inline]
    pub fn medium(self) -> &'a mut W {
        self.variant(::gpiof::ospeedr::OSPEEDR15W::MEDIUM)
    }
    #[doc = "`11`"]
    #[inline]
    pub fn high(self) -> &'a mut W {
        self.variant(::gpiof::ospeedr::OSPEEDR15W::HIGH)
    }
    #[doc = r" Writes raw bits to the field"]
    #[inline]
    pub unsafe fn bits(self, value: u8) -> &'a mut W {
        const MASK: u8 = 3;
        const OFFSET: u8 = 30;
        self.w.bits &= !((MASK as u32) << OFFSET);
        self.w.bits |= ((value & MASK) as u32) << OFFSET;
        self.w
    }
}
#[doc = "Values that can be written to the field `OSPEEDR14`"]
pub type OSPEEDR14W = ::gpiof::ospeedr::OSPEEDR15W;
#[doc = r" Proxy"]
pub struct _OSPEEDR14W<'a> {
    w: &'a mut W,
}
impl<'a> _OSPEEDR14W<'a> {
    #[doc = r" Writes `variant` to the field"]
    #[inline]
    pub fn variant(self, variant: OSPEEDR14W) -> &'a mut W {
        unsafe { self.bits(variant._bits()) }
    }
    #[doc = "`0`"]
    #[inline]
    pub fn low(self) -> &'a mut W {
        self.variant(::gpiof::ospeedr::OSPEEDR15W::LOW)
    }
    #[doc = "`1`"]
    #[inline]
    pub fn medium(self) -> &'a mut W {
        self.variant(::gpiof::ospeedr::OSPEEDR15W::MEDIUM)
    }
    #[doc = "`11`"]
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
        self.variant(::gpiof::ospeedr::OSPEEDR15W::HIGH)
    }
    #[doc = r" Writes raw bits to the field"]
    #[inline]
    pub unsafe fn bits(self, value: u8) -> &'a mut W {
        const MASK: u8 = 3;
        const OFFSET: u8 = 4;
        self.w.bits &= !((MASK as u32) << OFFSET);
        self.w.bits |= ((value & MASK) as u32) << OFFSET;
        self.w
    }
}
#[doc = "Values that can be written to the field `OSPEEDR1`"]
pub type OSPEEDR1W = ::gpiof::ospeedr::OSPEEDR15W;
#[doc = r" Proxy"]
pub struct _OSPEEDR1W<'a> {
    w: &'a mut W,
}
impl<'a> _OSPEEDR1W<'a> {
    #[doc = r" Writes `variant` to the field"]
    #[inline]
    pub fn variant(self, variant: OSPEEDR1W) -> &'a mut W {
        unsafe { self.bits(variant._bits()) }
    }
    #[doc = "`0`"]
    #[inline]
    pub fn low(self) -> &'a mut W {
        self.variant(::gpiof::ospeedr::OSPEEDR15W::LOW)
    }
    #[doc = "`1`"]
    #[inline]
    pub fn medium(self) -> &'a mut W {
        self.variant(::gpiof::ospeedr::OSPEEDR15W::MEDIUM)
    }
    #[doc = "`11`"]
    #[inline]
    pub fn high(self) -> &'a mut W {
        self.variant(::gpiof::ospeedr::OSPEEDR15W::HIGH)
    }
    #[doc = r" Writes raw bits to the field"]
    #[inline]
    pub unsafe fn bits(self, value: u8) -> &'a mut W {
        const MASK: u8 = 3;
        const OFFSET: u8 = 2;
        self.w.bits &= !((MASK as u32) << OFFSET);
        self.w.bits |= ((value & MASK) as u32) << OFFSET;
        self.w
    }
}
#[doc = "Values that can be written to the field `OSPEEDR0`"]
pub type OSPEEDR0W = ::gpiof::ospeedr::OSPEEDR15W;
#[doc = r" Proxy"]
pub struct _OSPEEDR0W<'a> {
    w: &'a mut W,
}
impl<'a> _OSPEEDR0W<'a> {
    #[doc = r" Writes `variant` to the field"]
    #[inline]
    pub fn variant(self, variant: OSPEEDR0W) -> &'a mut W {
        unsafe { self.bits(variant._bits()) }
    }
    #[doc = "`0`"]
    #[inline]
    pub fn low(self) -> &'a mut W {
        self.variant(::gpiof::ospeedr::OSPEEDR15W::LOW)
    }
    #[doc = "`1`"]
    #[inline]
    pub fn medium(self) -> &'a mut W {
        self.variant(::gpiof::ospeedr::OSPEEDR15W::MEDIUM)
    }
    #[doc = "`11`"]
    #[inline]
    pub fn high(self) -> &'a mut W {
        self.variant(::gpiof::ospeedr::OSPEEDR15W::HIGH)
    }
    #[doc = r" Writes raw bits to the field"]
    #[inline]
    pub unsafe fn bits(self, value: u8) -> &'a mut W {
        const MASK: u8 = 3;
        const OFFSET: u8 = 0;
        self.w.bits &= !((MASK as u32) << OFFSET);
        self.w.bits |= ((value & MASK) as u32) << OFFSET;
        self.w
    }
}
impl R {
    #[doc = r" Value of the register as raw bits"]
    #[inline]
    pub fn bits(&self) -> u32 {
        self.bits
    }
    #[doc = "Bits 30:31 - Port x configuration bits (y = 0..15)"]
    #[inline]
    pub fn ospeedr15(&self) -> OSPEEDR15R {
        OSPEEDR15R::_from({
            const MASK: u8 = 3;
            const OFFSET: u8 = 30;
            ((self.bits >> OFFSET) & MASK as u32) as u8
        })
    }
    #[doc = "Bits 28:29 - Port x configuration bits (y = 0..15)"]
    #[inline]
    pub fn ospeedr14(&self) -> OSPEEDR14R {
        OSPEEDR14R::_from({
            const MASK: u8 = 3;
            const OFFSET: u8 = 28;
            ((self.bits >> OFFSET) & MASK as u32) as u8
        })
    }
    #[doc = "Bits 26:27 - Port x configuration bits (y = 0..15)"]
    #[inline]
    pub fn ospeedr13(&self) -> OSPEEDR13R {
        OSPEEDR13R::_from({
            const MASK: u8 = 3;
            const OFFSET: u8 = 26;
            ((self.bits >> OFFSET) & MASK as u32) as u8
        })
    }
    #[doc = "Bits 24:25 - Port x configuration bits (y = 0..15)"]
    #[inline]
    pub fn ospeedr12(&self) -> OSPEEDR12R {
        OSPEEDR12R::_from({
            const MASK: u8 = 3;
            const OFFSET: u8 = 24;
            ((self.bits >> OFFSET) & MASK as u32) as u8
        })
    }
    #[doc = "Bits 22:23 - Port x configuration bits (y = 0..15)"]
    #[inline]
    pub fn ospeedr11(&self) -> OSPEEDR11R {
        OSPEEDR11R::_from({
            const MASK: u8 = 3;
            const OFFSET: u8 = 22;
            ((self.bits >> OFFSET) & MASK as u32) as u8
        })
    }
    #[doc = "Bits 20:21 - Port x configuration bits (y = 0..15)"]
    #[inline]
    pub fn ospeedr10(&self) -> OSPEEDR10R {
        OSPEEDR10R::_from({
            const MASK: u8 = 3;
            const OFFSET: u8 = 20;
            ((self.bits >> OFFSET) & MASK as u32) as u8
        })
    }
    #[doc = "Bits 18:19 - Port x configuration bits (y = 0..15)"]
    #[inline]
    pub fn ospeedr9(&self) -> OSPEEDR9R {
        OSPEEDR9R::_from({
            const MASK: u8 = 3;
            const OFFSET: u8 = 18;
            ((self.bits >> OFFSET) & MASK as u32) as u8
        })
    }
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
    #[inline]
    pub fn ospeedr1(&mut self) -> _OSPEEDR1W {
        _OSPEEDR1W { w: self }
    }
    #[doc = "Bits 0:1 - Port x configuration bits (y = 0..15)"]
    #[inline]
    pub fn ospeedr0(&mut self) -> _OSPEEDR0W {
        _OSPEEDR0W { w: self }
    }
}
