kcuzner/rt-soldering-iron/rust/components/stm32f031x/src/gpioa/pupdr/mod.rs

#[doc = r" Value read from the register"]
pub struct R {
    bits: u32,
}
#[doc = r" Value to write to the register"]
pub struct W {
    bits: u32,
}
impl super::PUPDR {
    #[doc = r" Modifies the contents of the register"]
    #[inline]
    pub fn modify<F>(&self, f: F)
    where
        for<'w> F: FnOnce(&R, &'w mut W) -> &'w mut W,
    {
        let bits = self.register.get();
        let r = R { bits: bits };
        let mut w = W { bits: bits };
        f(&r, &mut w);
        self.register.set(w.bits);
    }
    #[doc = r" Reads the contents of the register"]
    #[inline]
    pub fn read(&self) -> R {
        R { bits: self.register.get() }
    }
    #[doc = r" Writes to the register"]
    #[inline]
    pub fn write<F>(&self, f: F)
    where
        F: FnOnce(&mut W) -> &mut W,
    {
        let mut w = W::reset_value();
        f(&mut w);
        self.register.set(w.bits);
    }
    #[doc = r" Writes the reset value to the register"]
    #[inline]
    pub fn reset(&self) {
        self.write(|w| w)
    }
}
#[doc = "Possible values of the field `PUPDR15`"]
pub type PUPDR15R = ::gpiof::pupdr::PUPDR15R;
#[doc = "Possible values of the field `PUPDR14`"]
pub type PUPDR14R = ::gpiof::pupdr::PUPDR15R;
#[doc = "Possible values of the field `PUPDR13`"]
pub type PUPDR13R = ::gpiof::pupdr::PUPDR15R;
#[doc = "Possible values of the field `PUPDR12`"]
pub type PUPDR12R = ::gpiof::pupdr::PUPDR15R;
#[doc = "Possible values of the field `PUPDR11`"]
pub type PUPDR11R = ::gpiof::pupdr::PUPDR15R;
#[doc = "Possible values of the field `PUPDR10`"]
pub type PUPDR10R = ::gpiof::pupdr::PUPDR15R;
#[doc = "Possible values of the field `PUPDR9`"]
pub type PUPDR9R = ::gpiof::pupdr::PUPDR15R;
#[doc = "Possible values of the field `PUPDR8`"]
pub type PUPDR8R = ::gpiof::pupdr::PUPDR15R;
#[doc = "Possible values of the field `PUPDR7`"]
pub type PUPDR7R = ::gpiof::pupdr::PUPDR15R;
#[doc = "Possible values of the field `PUPDR6`"]
pub type PUPDR6R = ::gpiof::pupdr::PUPDR15R;
#[doc = "Possible values of the field `PUPDR5`"]
pub type PUPDR5R = ::gpiof::pupdr::PUPDR15R;
#[doc = "Possible values of the field `PUPDR4`"]
pub type PUPDR4R = ::gpiof::pupdr::PUPDR15R;
#[doc = "Possible values of the field `PUPDR3`"]
pub type PUPDR3R = ::gpiof::pupdr::PUPDR15R;
#[doc = "Possible values of the field `PUPDR2`"]
pub type PUPDR2R = ::gpiof::pupdr::PUPDR15R;
#[doc = "Possible values of the field `PUPDR1`"]
pub type PUPDR1R = ::gpiof::pupdr::PUPDR15R;
#[doc = "Possible values of the field `PUPDR0`"]
pub type PUPDR0R = ::gpiof::pupdr::PUPDR15R;
#[doc = "Values that can be written to the field `PUPDR15`"]
pub type PUPDR15W = ::gpiof::pupdr::PUPDR15W;
#[doc = r" Proxy"]
pub struct _PUPDR15W<'a> {
    w: &'a mut W,
}
impl<'a> _PUPDR15W<'a> {
    #[doc = r" Writes `variant` to the field"]
    #[inline]
    pub fn variant(self, variant: PUPDR15W) -> &'a mut W {
        unsafe { self.bits(variant._bits()) }
    }
    #[doc = "`0`"]
    #[inline]
    pub fn none(self) -> &'a mut W {
        self.variant(::gpiof::pupdr::PUPDR15W::NONE)
    }
    #[doc = "`1`"]
    #[inline]
    pub fn pullup(self) -> &'a mut W {
        self.variant(::gpiof::pupdr::PUPDR15W::PULLUP)
    }
    #[doc = "`10`"]
    #[inline]
    pub fn pulldown(self) -> &'a mut W {
        self.variant(::gpiof::pupdr::PUPDR15W::PULLDOWN)
    }
    #[doc = r" Writes raw bits to the field"]
    #[inline]
    pub unsafe fn bits(self, value: u8) -> &'a mut W {
        const MASK: u8 = 3;
        const OFFSET: u8 = 30;
        self.w.bits &= !((MASK as u32) << OFFSET);
        self.w.bits |= ((value & MASK) as u32) << OFFSET;
        self.w
    }
}
#[doc = "Values that can be written to the field `PUPDR14`"]
pub type PUPDR14W = ::gpiof::pupdr::PUPDR15W;
#[doc = r" Proxy"]
pub struct _PUPDR14W<'a> {
    w: &'a mut W,
}
impl<'a> _PUPDR14W<'a> {
    #[doc = r" Writes `variant` to the field"]
    #[inline]
    pub fn variant(self, variant: PUPDR14W) -> &'a mut W {
        unsafe { self.bits(variant._bits()) }
    }
    #[doc = "`0`"]
    #[inline]
    pub fn none(self) -> &'a mut W {
        self.variant(::gpiof::pupdr::PUPDR15W::NONE)
    }
    #[doc = "`1`"]
    #[inline]
    pub fn pullup(self) -> &'a mut W {
        self.variant(::gpiof::pupdr::PUPDR15W::PULLUP)
    }
    #[doc = "`10`"]
    #[inline]
    pub fn pulldown(self) -> &'a mut W {
        self.variant(::gpiof::pupdr::PUPDR15W::PULLDOWN)
    }
    #[doc = r" Writes raw bits to the field"]
    #[inline]
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
pub type PUPDR1W = ::gpiof::pupdr::PUPDR15W;
#[doc = r" Proxy"]
pub struct _PUPDR1W<'a> {
    w: &'a mut W,
}
impl<'a> _PUPDR1W<'a> {
    #[doc = r" Writes `variant` to the field"]
    #[inline]
    pub fn variant(self, variant: PUPDR1W) -> &'a mut W {
        unsafe { self.bits(variant._bits()) }
    }
    #[doc = "`0`"]
    #[inline]
    pub fn none(self) -> &'a mut W {
        self.variant(::gpiof::pupdr::PUPDR15W::NONE)
    }
    #[doc = "`1`"]
    #[inline]
    pub fn pullup(self) -> &'a mut W {
        self.variant(::gpiof::pupdr::PUPDR15W::PULLUP)
    }
    #[doc = "`10`"]
    #[inline]
    pub fn pulldown(self) -> &'a mut W {
        self.variant(::gpiof::pupdr::PUPDR15W::PULLDOWN)
    }
    #[doc = r" Writes raw bits to the field"]
    #[inline]
    pub unsafe fn bits(self, value: u8) -> &'a mut W {
        const MASK: u8 = 3;
        const OFFSET: u8 = 2;
        self.w.bits &= !((MASK as u32) << OFFSET);
        self.w.bits |= ((value & MASK) as u32) << OFFSET;
        self.w
    }
}
#[doc = "Values that can be written to the field `PUPDR0`"]
pub type PUPDR0W = ::gpiof::pupdr::PUPDR15W;
#[doc = r" Proxy"]
pub struct _PUPDR0W<'a> {
    w: &'a mut W,
}
impl<'a> _PUPDR0W<'a> {
    #[doc = r" Writes `variant` to the field"]
    #[inline]
    pub fn variant(self, variant: PUPDR0W) -> &'a mut W {
        unsafe { self.bits(variant._bits()) }
    }
    #[doc = "`0`"]
    #[inline]
    pub fn none(self) -> &'a mut W {
        self.variant(::gpiof::pupdr::PUPDR15W::NONE)
    }
    #[doc = "`1`"]
    #[inline]
    pub fn pullup(self) -> &'a mut W {
        self.variant(::gpiof::pupdr::PUPDR15W::PULLUP)
    }
    #[doc = "`10`"]
    #[inline]
    pub fn pulldown(self) -> &'a mut W {
        self.variant(::gpiof::pupdr::PUPDR15W::PULLDOWN)
    }
    #[doc = r" Writes raw bits to the field"]
    #[inline]
    pub unsafe fn bits(self, value: u8) -> &'a mut W {
        const MASK: u8 = 3;
        const OFFSET: u8 = 0;
        self.w.bits &= !((MASK as u32) << OFFSET);
        self.w.bits |= ((value & MASK) as u32) << OFFSET;
        self.w
    }
}
impl R {
    #[doc = r" Value of the register as raw bits"]
    #[inline]
    pub fn bits(&self) -> u32 {
        self.bits
    }
    #[doc = "Bits 30:31 - Port x configuration bits (y = 0..15)"]
    #[inline]
    pub fn pupdr15(&self) -> PUPDR15R {
        PUPDR15R::_from({
            const MASK: u8 = 3;
            const OFFSET: u8 = 30;
            ((self.bits >> OFFSET) & MASK as u32) as u8
        })
    }
    #[doc = "Bits 28:29 - Port x configuration bits (y = 0..15)"]
    #[inline]
    pub fn pupdr14(&self) -> PUPDR14R {
        PUPDR14R::_from({
            const MASK: u8 = 3;
            const OFFSET: u8 = 28;
            ((self.bits >> OFFSET) & MASK as u32) as u8
        })
    }
    #[doc = "Bits 26:27 - Port x configuration bits (y = 0..15)"]
    #[inline]
    pub fn pupdr13(&self) -> PUPDR13R {
        PUPDR13R::_from({
            const MASK: u8 = 3;
            const OFFSET: u8 = 26;
            ((self.bits >> OFFSET) & MASK as u32) as u8
        })
    }
    #[doc = "Bits 24:25 - Port x configuration bits (y = 0..15)"]
    #[inline]
    pub fn pupdr12(&self) -> PUPDR12R {
        PUPDR12R::_from({
            const MASK: u8 = 3;
            const OFFSET: u8 = 24;
            ((self.bits >> OFFSET) & MASK as u32) as u8
        })
    }
    #[doc = "Bits 22:23 - Port x configuration bits (y = 0..15)"]
    #[inline]
    pub fn pupdr11(&self) -> PUPDR11R {
        PUPDR11R::_from({
            const MASK: u8 = 3;
            const OFFSET: u8 = 22;
            ((self.bits >> OFFSET) & MASK as u32) as u8
        })
    }
    #[doc = "Bits 20:21 - Port x configuration bits (y = 0..15)"]
    #[inline]
    pub fn pupdr10(&self) -> PUPDR10R {
        PUPDR10R::_from({
            const MASK: u8 = 3;
            const OFFSET: u8 = 20;
            ((self.bits >> OFFSET) & MASK as u32) as u8
        })
    }
    #[doc = "Bits 18:19 - Port x configuration bits (y = 0..15)"]
    #[inline]
    pub fn pupdr9(&self) -> PUPDR9R {
        PUPDR9R::_from({
            const MASK: u8 = 3;
            const OFFSET: u8 = 18;
            ((self.bits >> OFFSET) & MASK as u32) as u8
        })
    }
    #[doc = "Bits 16:17 - Port x configuration bits (y = 0..15)"]
    #[inline]
    pub fn pupdr8(&self) -> PUPDR8R {
        PUPDR8R::_from({
            const MASK: u8 = 3;
            const OFFSET: u8 = 16;
            ((self.bits >> OFFSET) & MASK as u32) as u8
        })
    }
    #[doc = "Bits 14:15 - Port x configuration bits (y = 0..15)"]
    #[inline]
    pub fn pupdr7(&self) -> PUPDR7R {
        PUPDR7R::_from({
            const MASK: u8 = 3;
            const OFFSET: u8 = 14;
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
    }
    #[doc = "Bits 6:7 - Port x configuration bits (y = 0..15)"]
    #[inline]
    pub fn pupdr3(&mut self) -> _PUPDR3W {
        _PUPDR3W { w: self }
    }
    #[doc = "Bits 4:5 - Port x configuration bits (y = 0..15)"]
    #[inline]
    pub fn pupdr2(&mut self) -> _PUPDR2W {
        _PUPDR2W { w: self }
    }
    #[doc = "Bits 2:3 - Port x configuration bits (y = 0..15)"]
    #[inline]
    pub fn pupdr1(&mut self) -> _PUPDR1W {
        _PUPDR1W { w: self }
    }
    #[doc = "Bits 0:1 - Port x configuration bits (y = 0..15)"]
    #[inline]
    pub fn pupdr0(&mut self) -> _PUPDR0W {
        _PUPDR0W { w: self }
    }
}
