kcuzner/rt-soldering-iron/rust/components/stm32f031x/src/syscfg/cfgr1/mod.rs

#[doc = r" Value read from the register"]
pub struct R {
    bits: u32,
}
#[doc = r" Value to write to the register"]
pub struct W {
    bits: u32,
}
impl super::CFGR1 {
    #[doc = r" Modifies the contents of the register"]
    #[inline]
    pub fn modify<F>(&self, f: F)
    where
        for<'w> F: FnOnce(&R, &'w mut W) -> &'w mut W,
    {
        let bits = self.register.get();
        let r = R { bits: bits };
        let mut w = W { bits: bits };
        f(&r, &mut w);
        self.register.set(w.bits);
    }
    #[doc = r" Reads the contents of the register"]
    #[inline]
    pub fn read(&self) -> R {
        R { bits: self.register.get() }
    }
    #[doc = r" Writes to the register"]
    #[inline]
    pub fn write<F>(&self, f: F)
    where
        F: FnOnce(&mut W) -> &mut W,
    {
        let mut w = W::reset_value();
        f(&mut w);
        self.register.set(w.bits);
    }
    #[doc = r" Writes the reset value to the register"]
    #[inline]
    pub fn reset(&self) {
        self.write(|w| w)
    }
}
#[doc = r" Value of the field"]
pub struct I2C_PB9_FMR {
    bits: bool,
}
impl I2C_PB9_FMR {
    #[doc = r" Value of the field as raw bits"]
    #[inline]
    pub fn bit(&self) -> bool {
        self.bits
    }
    #[doc = r" Returns `true` if the bit is clear (0)"]
    #[inline]
    pub fn bit_is_clear(&self) -> bool {
        !self.bit()
    }
    #[doc = r" Returns `true` if the bit is set (1)"]
    #[inline]
    pub fn bit_is_set(&self) -> bool {
        self.bit()
    }
}
#[doc = r" Value of the field"]
pub struct I2C_PB8_FMR {
    bits: bool,
}
impl I2C_PB8_FMR {
    #[doc = r" Value of the field as raw bits"]
    #[inline]
    pub fn bit(&self) -> bool {
        self.bits
    }
    #[doc = r" Returns `true` if the bit is clear (0)"]
    #[inline]
    pub fn bit_is_clear(&self) -> bool {
        !self.bit()
    }
    #[doc = r" Returns `true` if the bit is set (1)"]
    #[inline]
    pub fn bit_is_set(&self) -> bool {
        self.bit()
    }
}
#[doc = r" Value of the field"]
pub struct I2C_PB7_FMR {
    bits: bool,
}
impl I2C_PB7_FMR {
    #[doc = r" Value of the field as raw bits"]
    #[inline]
    pub fn bit(&self) -> bool {
        self.bits
    }
    #[doc = r" Returns `true` if the bit is clear (0)"]
    #[inline]
    pub fn bit_is_clear(&self) -> bool {
        !self.bit()
    }
    #[doc = r" Returns `true` if the bit is set (1)"]
    #[inline]
    pub fn bit_is_set(&self) -> bool {
        self.bit()
    }
}
#[doc = r" Value of the field"]
pub struct I2C_PB6_FMR {
    bits: bool,
}
impl I2C_PB6_FMR {
    #[doc = r" Value of the field as raw bits"]
    #[inline]
    pub fn bit(&self) -> bool {
        self.bits
    }
    #[doc = r" Returns `true` if the bit is clear (0)"]
    #[inline]
    pub fn bit_is_clear(&self) -> bool {
        !self.bit()
    }
    #[doc = r" Returns `true` if the bit is set (1)"]
    #[inline]
    pub fn bit_is_set(&self) -> bool {
        self.bit()
    }
}
#[doc = r" Value of the field"]
pub struct TIM17_DMA_RMPR {
    bits: bool,
}
impl TIM17_DMA_RMPR {
    #[doc = r" Value of the field as raw bits"]
    #[inline]
    pub fn bit(&self) -> bool {
        self.bits
    }
    #[doc = r" Returns `true` if the bit is clear (0)"]
    #[inline]
    pub fn bit_is_clear(&self) -> bool {
        !self.bit()
    }
    #[doc = r" Returns `true` if the bit is set (1)"]
    #[inline]
    pub fn bit_is_set(&self) -> bool {
        self.bit()
    }
}
#[doc = r" Value of the field"]
pub struct TIM16_DMA_RMPR {
    bits: bool,
}
impl TIM16_DMA_RMPR {
    #[doc = r" Value of the field as raw bits"]
    #[inline]
    pub fn bit(&self) -> bool {
        self.bits
    }
    #[doc = r" Returns `true` if the bit is clear (0)"]
    #[inline]
    pub fn bit_is_clear(&self) -> bool {
        !self.bit()
    }
    #[doc = r" Returns `true` if the bit is set (1)"]
    #[inline]
    pub fn bit_is_set(&self) -> bool {
        self.bit()
    }
}
#[doc = r" Value of the field"]
pub struct USART1_RX_DMA_RMPR {
    bits: bool,
}
impl USART1_RX_DMA_RMPR {
    #[doc = r" Value of the field as raw bits"]
    #[inline]
    pub fn bit(&self) -> bool {
        self.bits
    }
    #[doc = r" Returns `true` if the bit is clear (0)"]
    #[inline]
    pub fn bit_is_clear(&self) -> bool {
        !self.bit()
    }
    #[doc = r" Returns `true` if the bit is set (1)"]
    #[inline]
    pub fn bit_is_set(&self) -> bool {
        self.bit()
    }
}
#[doc = r" Value of the field"]
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
        self.w
    }
}
#[doc = r" Proxy"]
pub struct _TIM16_DMA_RMPW<'a> {
    w: &'a mut W,
}
impl<'a> _TIM16_DMA_RMPW<'a> {
    #[doc = r" Sets the field bit"]
    pub fn set_bit(self) -> &'a mut W {
        self.bit(true)
    }
    #[doc = r" Clears the field bit"]
    pub fn clear_bit(self) -> &'a mut W {
        self.bit(false)
    }
    #[doc = r" Writes raw bits to the field"]
    #[inline]
    pub fn bit(self, value: bool) -> &'a mut W {
        const MASK: bool = true;
        const OFFSET: u8 = 11;
        self.w.bits &= !((MASK as u32) << OFFSET);
        self.w.bits |= ((value & MASK) as u32) << OFFSET;
        self.w
    }
}
#[doc = r" Proxy"]
pub struct _USART1_RX_DMA_RMPW<'a> {
    w: &'a mut W,
}
impl<'a> _USART1_RX_DMA_RMPW<'a> {
    #[doc = r" Sets the field bit"]
    pub fn set_bit(self) -> &'a mut W {
        self.bit(true)
    }
    #[doc = r" Clears the field bit"]
    pub fn clear_bit(self) -> &'a mut W {
        self.bit(false)
    }
    #[doc = r" Writes raw bits to the field"]
    #[inline]
    pub fn bit(self, value: bool) -> &'a mut W {
        const MASK: bool = true;
        const OFFSET: u8 = 10;
        self.w.bits &= !((MASK as u32) << OFFSET);
        self.w.bits |= ((value & MASK) as u32) << OFFSET;
        self.w
    }
}
#[doc = r" Proxy"]
pub struct _USART1_TX_DMA_RMPW<'a> {
    w: &'a mut W,
}
impl<'a> _USART1_TX_DMA_RMPW<'a> {
    #[doc = r" Sets the field bit"]
    pub fn set_bit(self) -> &'a mut W {
        self.bit(true)
    }
    #[doc = r" Clears the field bit"]
    pub fn clear_bit(self) -> &'a mut W {
        self.bit(false)
    }
    #[doc = r" Writes raw bits to the field"]
    #[inline]
    pub fn bit(self, value: bool) -> &'a mut W {
        const MASK: bool = true;
        const OFFSET: u8 = 9;
        self.w.bits &= !((MASK as u32) << OFFSET);
        self.w.bits |= ((value & MASK) as u32) << OFFSET;
        self.w
    }
}
#[doc = r" Proxy"]
pub struct _ADC_DMA_RMPW<'a> {
    w: &'a mut W,
}
impl<'a> _ADC_DMA_RMPW<'a> {
    #[doc = r" Sets the field bit"]
    pub fn set_bit(self) -> &'a mut W {
        self.bit(true)
    }
    #[doc = r" Clears the field bit"]
    pub fn clear_bit(self) -> &'a mut W {
        self.bit(false)
    }
    #[doc = r" Writes raw bits to the field"]
    #[inline]
    pub fn bit(self, value: bool) -> &'a mut W {
        const MASK: bool = true;
        const OFFSET: u8 = 8;
        self.w.bits &= !((MASK as u32) << OFFSET);
        self.w.bits |= ((value & MASK) as u32) << OFFSET;
        self.w
    }
}
#[doc = r" Proxy"]
pub struct _MEM_MODEW<'a> {
    w: &'a mut W,
}
impl<'a> _MEM_MODEW<'a> {
    #[doc = r" Writes raw bits to the field"]
    #[inline]
    pub unsafe fn bits(self, value: u8) -> &'a mut W {
        const MASK: u8 = 3;
        const OFFSET: u8 = 0;
        self.w.bits &= !((MASK as u32) << OFFSET);
        self.w.bits |= ((value & MASK) as u32) << OFFSET;
        self.w
    }
}
impl R {
    #[doc = r" Value of the register as raw bits"]
    #[inline]
    pub fn bits(&self) -> u32 {
        self.bits
    }
    #[doc = "Bit 19 - Fast Mode Plus (FM+) driving capability activation bits."]
    #[inline]
    pub fn i2c_pb9_fm(&self) -> I2C_PB9_FMR {
        let bits = {
            const MASK: bool = true;
            const OFFSET: u8 = 19;
            ((self.bits >> OFFSET) & MASK as u32) != 0
        };
        I2C_PB9_FMR { bits }
    }
    #[doc = "Bit 18 - Fast Mode Plus (FM+) driving capability activation bits."]
    #[inline]
    pub fn i2c_pb8_fm(&self) -> I2C_PB8_FMR {
        let bits = {
            const MASK: bool = true;
            const OFFSET: u8 = 18;
            ((self.bits >> OFFSET) & MASK as u32) != 0
        };
        I2C_PB8_FMR { bits }
    }
    #[doc = "Bit 17 - Fast Mode Plus (FM+) driving capability activation bits."]
    #[inline]
    pub fn i2c_pb7_fm(&self) -> I2C_PB7_FMR {
        let bits = {
            const MASK: bool = true;
            const OFFSET: u8 = 17;
            ((self.bits >> OFFSET) & MASK as u32) != 0
        };
        I2C_PB7_FMR { bits }
    }
    #[doc = "Bit 16 - Fast Mode Plus (FM+) driving capability activation bits."]
    #[inline]
    pub fn i2c_pb6_fm(&self) -> I2C_PB6_FMR {
        let bits = {
            const MASK: bool = true;
            const OFFSET: u8 = 16;
            ((self.bits >> OFFSET) & MASK as u32) != 0
        };
        I2C_PB6_FMR { bits }
    }
    #[doc = "Bit 12 - TIM17 DMA request remapping bit"]
    #[inline]
    pub fn tim17_dma_rmp(&self) -> TIM17_DMA_RMPR {
        let bits = {
            const MASK: bool = true;
            const OFFSET: u8 = 12;
            ((self.bits >> OFFSET) & MASK as u32) != 0
        };
        TIM17_DMA_RMPR { bits }
    }
    #[doc = "Bit 11 - TIM16 DMA request remapping bit"]
    #[inline]
    pub fn tim16_dma_rmp(&self) -> TIM16_DMA_RMPR {
        let bits = {
            const MASK: bool = true;
            const OFFSET: u8 = 11;
            ((self.bits >> OFFSET) & MASK as u32) != 0
        };
        TIM16_DMA_RMPR { bits }
    }
    #[doc = "Bit 10 - USART1_RX DMA request remapping bit"]
    #[inline]
    pub fn usart1_rx_dma_rmp(&self) -> USART1_RX_DMA_RMPR {
        let bits = {
            const MASK: bool = true;
            const OFFSET: u8 = 10;
            ((self.bits >> OFFSET) & MASK as u32) != 0
        };
        USART1_RX_DMA_RMPR { bits }
    }
    #[doc = "Bit 9 - USART1_TX DMA remapping bit"]
    #[inline]
    pub fn usart1_tx_dma_rmp(&self) -> USART1_TX_DMA_RMPR {
        let bits = {
            const MASK: bool = true;
            const OFFSET: u8 = 9;
            ((self.bits >> OFFSET) & MASK as u32) != 0
        };
        USART1_TX_DMA_RMPR { bits }
    }
    #[doc = "Bit 8 - ADC DMA remapping bit"]
    #[inline]
    pub fn adc_dma_rmp(&self) -> ADC_DMA_RMPR {
        let bits = {
            const MASK: bool = true;
            const OFFSET: u8 = 8;
            ((self.bits >> OFFSET) & MASK as u32) != 0
        };
        ADC_DMA_RMPR { bits }
    }
    #[doc = "Bits 0:1 - Memory mapping selection bits"]
    #[inline]
    pub fn mem_mode(&self) -> MEM_MODER {
        let bits = {
            const MASK: u8 = 3;
            const OFFSET: u8 = 0;
            ((self.bits >> OFFSET) & MASK as u32) as u8
        };
        MEM_MODER { bits }
    }
}
impl W {
    #[doc = r" Reset value of the register"]
    #[inline]
    pub fn reset_value() -> W {
        W { bits: 0 }
    }
    #[doc = r" Writes raw bits to the register"]
    #[inline]
    pub unsafe fn bits(&mut self, bits: u32) -> &mut Self {
        self.bits = bits;
        self
    }
    #[doc = "Bit 19 - Fast Mode Plus (FM+) driving capability activation bits."]
    #[inline]
    pub fn i2c_pb9_fm(&mut self) -> _I2C_PB9_FMW {
        _I2C_PB9_FMW { w: self }
    }
    #[doc = "Bit 18 - Fast Mode Plus (FM+) driving capability activation bits."]
    #[inline]
    pub fn i2c_pb8_fm(&mut self) -> _I2C_PB8_FMW {
        _I2C_PB8_FMW { w: self }
    }
    #[doc = "Bit 17 - Fast Mode Plus (FM+) driving capability activation bits."]
    #[inline]
    pub fn i2c_pb7_fm(&mut self) -> _I2C_PB7_FMW {
        _I2C_PB7_FMW { w: self }
    }
    #[doc = "Bit 16 - Fast Mode Plus (FM+) driving capability activation bits."]
    #[inline]
    pub fn i2c_pb6_fm(&mut self) -> _I2C_PB6_FMW {
        _I2C_PB6_FMW { w: self }
    }
    #[doc = "Bit 12 - TIM17 DMA request remapping bit"]
    #[inline]
    pub fn tim17_dma_rmp(&mut self) -> _TIM17_DMA_RMPW {
        _TIM17_DMA_RMPW { w: self }
    }
    #[doc = "Bit 11 - TIM16 DMA request remapping bit"]
    #[inline]
    pub fn tim16_dma_rmp(&mut self) -> _TIM16_DMA_RMPW {
        _TIM16_DMA_RMPW { w: self }
    }
    #[doc = "Bit 10 - USART1_RX DMA request remapping bit"]
    #[inline]
    pub fn usart1_rx_dma_rmp(&mut self) -> _USART1_RX_DMA_RMPW {
        _USART1_RX_DMA_RMPW { w: self }
    }
    #[doc = "Bit 9 - USART1_TX DMA remapping bit"]
    #[inline]
    pub fn usart1_tx_dma_rmp(&mut self) -> _USART1_TX_DMA_RMPW {
        _USART1_TX_DMA_RMPW { w: self }
    }
    #[doc = "Bit 8 - ADC DMA remapping bit"]
    #[inline]
    pub fn adc_dma_rmp(&mut self) -> _ADC_DMA_RMPW {
        _ADC_DMA_RMPW { w: self }
    }
    #[doc = "Bits 0:1 - Memory mapping selection bits"]
    #[inline]
    pub fn mem_mode(&mut self) -> _MEM_MODEW {
        _MEM_MODEW { w: self }
    }
}
