kcuzner/rt-soldering-iron/rust/components/stm32f031x-hal/src/adc.rs

//! ADC Abstraction

use core::marker::PhantomData;

use nb;

use stm32f031x::ADC;

use gpio;
use rcc::{APB2};

/// Trait applied to pins that are analog capable
pub trait IntoAnalog<AnalogPin> {
    /// GPIO regs
    type Regs;

    /// Switches this pin into an analog input
    fn into_analog_input(self, regs: &mut Self::Regs) -> AnalogPin;
}

/// Trait applied when a particular pin in a particular mode can be used as an analog input
///
/// This is unsafe because not everything can be an analog pin
pub unsafe trait AnalogPin {
    const CHANNEL: u32;
}

/// Macro for declaring an analog pin, to reduce code repetition
macro_rules! analog_pin {
    ($CHx:expr, ($PXi:ident, $gpiox:ident)) => {
        impl<Mode> IntoAnalog<gpio::$gpiox::$PXi<gpio::Analog>> for gpio::$gpiox::$PXi<Mode> {
            type Regs = gpio::$gpiox::Regs;

            fn into_analog_input(self, regs: &mut Self::Regs) -> gpio::$gpiox::$PXi<gpio::Analog> {
                // The invoker of this macro knows that this pin really is analog
                // so this is safe.
                unsafe { self.into_analog(regs) }
            }
        }

        unsafe impl AnalogPin for gpio::$gpiox::$PXi<gpio::Analog> {
            const CHANNEL: u32 = $CHx;
        }
    }
}

analog_pin!(0, (PA0, gpioa));
analog_pin!(1, (PA1, gpioa));
analog_pin!(2, (PA2, gpioa));
analog_pin!(3, (PA3, gpioa));
analog_pin!(4, (PA4, gpioa));
analog_pin!(5, (PA5, gpioa));
analog_pin!(6, (PA6, gpioa));
analog_pin!(7, (PA7, gpioa));
analog_pin!(8, (PB0, gpiob));
analog_pin!(9, (PB1, gpiob));

/// Extention trait for the ADC instance
pub trait AdcExt {
    /// Bus type for clock enables
    type Bus;

    type Constrained;

    fn constrain(self, bus: &mut Self::Bus) -> Self::Constrained;
}

impl AdcExt for ADC {
    type Bus = APB2;
    type Constrained = Uncalibrated;

    fn constrain(self, bus: &mut APB2) -> Uncalibrated {
        Uncalibrated::new(self, bus)
    }
}

/// Resolution of the analog to digital converter
#[derive(Copy, Clone)]
pub enum AdcResolution {
    /// 12-bit resolution
    TwelveBit,
    /// 10-bit resolution
    TenBit,
    /// 8-bit resolution
    EightBit,
    /// 6-bit resolution
    SixBit,
}

/// Alignment of an ADC value
#[derive(Copy, Clone)]
pub enum AdcAlignment {
    /// Left alignment
    Left,
    /// Right alignment
    Right,
}

/// Holds a raw ADC value
///
/// Created directly from the current value of the data register
#[derive(Copy, Clone)]
pub struct AdcValue {
    resolution: AdcResolution,
    alignment: AdcAlignment,
    value: u16,
}

impl AdcValue {
    /// Creates a new AdcValue from the contents of DR
    ///
    /// This function is unsafe because it performs several sequential reads. The caller must
    /// ensure that it has exclusive access to the ADC before calling.
    unsafe fn new() -> AdcValue {
        let value = (*ADC::ptr()).dr.read().data().bits();
        let cfgr1 = (*ADC::ptr()).cfgr1.read();
        let resolution = match cfgr1.res().bits() {
            0b00 => AdcResolution::TwelveBit,
            0b01 => AdcResolution::TenBit,
            0b10 => AdcResolution::EightBit,
            0b11 => AdcResolution::SixBit,
            _ => unreachable!(),
        };
        let alignment = match cfgr1.align().bit() {
            true => AdcAlignment::Left,
            false => AdcAlignment::Right,
        };
        AdcValue {
            resolution: resolution,
            alignment: alignment,
            value: value
        }
    }

    /// Gets the resolution of this ADC value
    pub fn resolution(&self) -> AdcResolution {
        self.resolution
    }

    /// Gets the alignment of this ADC value
    pub fn alignment(&self) -> AdcAlignment {
        self.alignment
    }

    /// Gets the raw ADC value
    pub fn raw(&self) -> u32 {
        self.value as u32
    }

    /// Gets the right-aligned raw ADC value
    pub fn raw_right(&self) -> u32 {
         match self.alignment() {
            AdcAlignment::Left => match self.resolution() {
                AdcResolution::TwelveBit => self.raw() >> 4,
                AdcResolution::TenBit => self.raw() >> 6,
                AdcResolution::EightBit => self.raw() >> 8,
                AdcResolution::SixBit => self.raw() >> 2,
            },
            _ => self.raw(),
        }
    }
}

impl From<AdcValue> for u8 {
    /// Converts an ADC value into a u8, scaling to the range by shifting
    fn from(v: AdcValue) -> u8 {
        let value = match v.resolution() {
            AdcResolution::TwelveBit => v.raw_right() >> 4,
            AdcResolution::TenBit => v.raw_right() >> 2,
            AdcResolution::EightBit => v.raw_right(),
            AdcResolution::SixBit => v.raw_right() << 2,
        };
        value as u8
    }
}

impl From<AdcValue> for u16 {
    /// Converts an ADC value into a u16, scaling to the range by shifting
    fn from(v: AdcValue) -> u16 {
        let value = match v.resolution() {
            AdcResolution::TwelveBit => v.raw_right() << 4,
            AdcResolution::TenBit => v.raw_right() << 6,
            AdcResolution::EightBit => v.raw_right() << 8,
            AdcResolution::SixBit => v.raw_right() << 10,
        };
        value as u16
    }
}

impl From<AdcValue> for u32 {
    /// Converts an ADC value into a u32, scaling to the range by shifting
    fn from(v: AdcValue) -> u32 {
        let sixteen: u16 = v.into();
        (sixteen as u32) << 16
    }
}

/// Steps performed during the calibration phase
enum CalibrationState {
    Disabling,
    Calibrating,
    Enabling,
}

/// Uncalibrated ADC
///
/// The ADC is uncalibrated out of reset, so this instance will immediately
/// begin calibration. Once a CalibratedToken is produced, a Calibrated ADC
/// can be created.
pub struct Uncalibrated {
    state: CalibrationState
}

impl Uncalibrated {
    /// Creates a new uncalibrated ADC instance
    ///
    /// By default, the ADC is assumed to be uncalibrated, so this is the only
    /// thing that can be constructed from an ADC instance.
    pub fn new(_adc: ADC, bus: &mut APB2) -> Self {
        // Enable the ADC clock
        bus.enr().modify(|_, w| w.adcen().bit(true));
        // We are a proxy for ADC, so this is safe
        // Step 1: Disable the ADC
        if unsafe { (*ADC::ptr()).cr.read().aden().bit() } {
            unsafe { (*ADC::ptr()).cr.modify(|_, w| w.addis().bit(true)) };
        }
        Uncalibrated { state: CalibrationState::Disabling }
    }

    pub fn poll(&mut self) -> nb::Result<CalibrationToken, !> {
        // We are a proxy for ADC, so pointer ops are safe (note mut self)
        match self.state {
            CalibrationState::Disabling => {
                // Have we finished disabling the ADC?
                if !unsafe { (*ADC::ptr()).cr.read().aden().bit() } {
                    //we have, so let's begin calibration
                    unsafe { (*ADC::ptr()).cfgr1.modify(|_, w| w.dmaen().bit(false)) };
                    unsafe { (*ADC::ptr()).cr.modify(|_, w| w.adcal().bit(true)) };
                    self.state = CalibrationState::Calibrating;
                }
                Err(nb::Error::WouldBlock)
            },
            CalibrationState::Calibrating => {
                // Have we finished calibration? adcal is cleared by hardware
                if !unsafe { (*ADC::ptr()).cr.read().adcal().bit() } {
                    // we have, so enable the ADC
                    unsafe { (*ADC::ptr()).isr.write(|w| w.adrdy().bit(true)) };
                    unsafe { (*ADC::ptr()).cr.modify(|_, w| w.aden().bit(true)) };
                    self.state = CalibrationState::Enabling;
                }
                Err(nb::Error::WouldBlock)
            },
            CalibrationState::Enabling => {
                // Have we enabled the ADC?
                if unsafe { (*ADC::ptr()).isr.read().adrdy().bit() } {
                    // we have, so produce a calibration token
                    Ok(CalibrationToken::new())
                }
                else {
                    Err(nb::Error::WouldBlock)
                }
            }
        }
    }
}

/// Token produced when the ADC has been calibrated
pub struct CalibrationToken {
    _0: ()
}

impl CalibrationToken {
    /// Creates a new token meaning that the ADC has been calibrated
    fn new() -> Self {
        CalibrationToken { _0: () }
    }

    pub fn finish(self, adc: Uncalibrated) -> Calibrated {
        Calibrated::new(self, adc)
    }
}

/// Calibrated ADC
pub struct Calibrated {
    _0: ()
}

impl Calibrated {
    /// Creates a new calibrated ADC instance
    fn new(_ct: CalibrationToken, _: Uncalibrated) -> Self {
        Calibrated { _0: () }
    }

    /// Begins a single analog conversion
    pub fn single<P>(self, pin: P) -> SingleConversion<P>
        where P: AnalogPin
    {
        SingleConversion::new(self, pin)
    }
}

/// ADC conversion of a single pin
pub struct SingleConversion<P> where P: AnalogPin {
    adc: Calibrated,
    pin: P,
}

impl<P: AnalogPin> SingleConversion<P> {
    /// Begins a new conversion
    ///
    /// This can either be created directly by way of this method, or by calling
    /// the "single" method on the Calibrated instance
    pub fn new(adc: Calibrated, pin: P) -> Self {
        // adc is the proxy for ADC and we own it now. We are the proxy.
        // Clear the EOC flag
        unsafe { (*ADC::ptr()).isr.write(|w| w.eoc().bit(true)) };
        // Set the channel
        let channel_mask = 1 << P::CHANNEL;
        unsafe { (*ADC::ptr()).chselr.write(|w| w.bits(channel_mask)) }
        // Start the conversion
        unsafe { (*ADC::ptr()).cr.modify(|_, w| w.adstart().bit(true)) }
        SingleConversion { adc: adc, pin: pin }
    }

    /// Polls the conversion to completion
    pub fn poll(&mut self) -> nb::Result<ConversionComplete<P>, !> {
        // We own the proxy, so these accesses are safe
        if unsafe { (*ADC::ptr()).isr.read().eoc().bit() } {
            // The conversion is complete
            Ok(ConversionComplete::new())
        }
        else {
            Err(nb::Error::WouldBlock)
        }
    }
}

/// Conversion complete token.
///
/// This token is created when a conversion for a pin has been completed
pub struct ConversionComplete<P> where P: AnalogPin {
    _0: PhantomData<P>
}

impl<P: AnalogPin> ConversionComplete<P> {
    /// Creates a new conversion complete token
    fn new() -> Self {
        ConversionComplete { _0: PhantomData }
    }
    /// Finishes a single conversion
    ///
    /// This returns the ADC object, the pin that was being used for conversion,
    /// and the value
    pub fn finish(self, conv: SingleConversion<P>) -> (Calibrated, P, AdcValue) {
        // we have the conv, which has the adc, so this is safe
        let value = unsafe { AdcValue::new() };
        (conv.adc, conv.pin, value)
    }
}
