kcuzner/rt-soldering-iron/(commit log)

2017-05-31 Initial commit
    First pass at placement
    [analog-frontend.sch, digital-control.sch, power-supplies.sch, rt-soldering-iron.kicad_pcb, rt-soldering-iron.sch]
2017-06-01 Added buzzer, fixed footprint errors, and updated silkscreen
    The board is probably ready to be ordered
    [analog-frontend.sch, digital-control.sch, power-supplies.sch, rt-soldering-iron.kicad_pcb]
2017-06-03 Changed out the op amp and fixed oval holes for OSHPark
    I don't think I'm going to go with OSHPark. It seems they can't
    fabricate this thing.
    [analog-frontend.sch, digital-control.sch, power-supplies.sch, rt-soldering-iron.kicad_pcb, rt-soldering-iron.sch]
2017-06-15 Added initial firmware and flashing utilities
    The device is programmable as is on the PCB. Hooray!!
    [flash.cfg]
2017-06-17 Added FreeRTOS and C++ compilation
    C++ compliation is surprisingly lightweight. FreeRTOS was also made
    light by turning on the function-section switch on the compiler
    combined with gc-sections.
2017-06-18 Removed heap, fixed startup delay issue, added ssd1306 initialization
    The startup delay issue had to do with a problem in the port. It didn't
    reset the current value of the systick timer, meaning that it had to
    wait until it counted all the way down before the first tick would get
    executed. It turns out that this is just about a second on this
    processor running that the default speed. Resetting the CVR fixed this
    issue and now delays work fine if they occur within the first second of
    program start.
    [buzzer.cpp, main.cpp]
2017-06-18 Added SSD1306 display routine, increased I2C speed
    The display is able to send the buffer in about 45ms. This could
    probably be increased somewhat, but it is sufficiently fast for now.
2017-06-24 Added debounced buttons
2017-06-29 Fixed schematic to use USLetter paper
    [analog-frontend.sch, digital-control.sch, power-supplies.sch, rt-soldering-iron.sch]
2017-07-01 Started second revision, added a comparator and eFuse
    The comparator has no hysteresis in its current configuration, so that
    will need to be fixed.
    [analog-frontend.sch, digital-control.sch, rt-soldering-iron.sch]
2017-07-01 Fixed buzzer mode setting
    [buzzer.cpp]
2017-07-01 Added initial heater implementation with ADC and DMA
    It works, but does not control the temperature.
2017-08-06 Changed all code to C in hopes of a better memory footprint
    A stack size of 120 was killer. I believe C should allow me to better
    control the size of stack allocations, especially in the cause of the
    autolock. The only sacrifice made here was automatic initialization
    since I was able to replicate the autolock with a technique used in
    avr-gcc.
    Code size was only reduced slightly. Without changing the stack size,
    memory usage was not reduced really at all.
    Also, queues have a footprint of 80 bytes.
2017-08-20 Removed comp, efuse. Added zener protection. Fixed OLED footprint.
    I may have destroyed a board by shorting the FB pin to ground. I left
    off the zener protection on Rev A. Never again.
    [analog-frontend.sch, power-supplies.sch, rt-soldering-iron.kicad_pcb, rt-soldering-iron.sch]
2017-08-20 Added overvoltage protection circuit to +3.3V
    Part selection is complete. There are things without part numbers.
    It uses a TL431 as a precision comparator with integrated voltage
    reference to activate a latch which both shuts down the regulator and
    throws a crobar across +3.3V. There is also space for a fuse on +3.3V
    (I'm thinking a PTC resettable fuse could go there, but I'm not sure
    what the tradeoffs are for that).
    [analog-frontend.sch, digital-control.sch, power-supplies.sch]
2017-08-31 Added overtemperature latching circuit with reset
    This uses a comparator to trigger the same latch type that is used on
    the OVP circuit.
    [analog-frontend.sch, digital-control.sch, power-supplies.sch]
2017-09-01 Fixed thermal cutoff circuit and finished footprint selection
    The main issue with the thermal cutoff was the open-collector maximum
    voltage. I had to find a (slightly more expensive) comparator with an
    output that was tolerant. Other comparators that would be instead
    tolerant of being run off 12V were about the same price.
    The fuse I'm not sure about. I'm just going to short it out. The
    regulator can handle a short circuit and so can the crowbar. I also
    couldn't decide where to put the feedback network. If I put it after the
    fuse it would compensate for any voltage drop across it. However, it
    would also cause the regulator to try to boost the voltage insanely high
    during a short circuit acr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
    [analog-frontend.sch, digital-control.sch, power-supplies.sch, rt-soldering-iron.sch]
2017-09-02 Changed out switch for two small side clicker ones
    Should make things a little easier to lay out and easier to modify
    later.
    [analog-frontend.sch, digital-control.sch, power-supplies.sch]
2017-09-23 Finished placement of all parts. Routed power supply.
    The board has been shrunk by 10mm or so. The elimination of the giant
    directional switch is the reason this is even possible.
    [analog-frontend.sch, digital-control.sch, power-supplies.sch, rt-soldering-iron.kicad_pcb]
2017-09-23 Completed initial routing
    [digital-control.sch, rt-soldering-iron.kicad_pcb]
2017-09-23 Initial silkscreen fixing
    [rt-soldering-iron.kicad_pcb]
2017-09-23 Changed programming header NCs to GNDs to avoid a bottleneck
    [rt-soldering-iron.kicad_pcb]
2017-09-23 Added tags to unused QFN pins except on accelerometer
    [rt-soldering-iron.kicad_pcb]
2017-10-15 Fixed some capacitor footprints
    [analog-frontend.sch, digital-control.sch, power-supplies.sch, rt-soldering-iron.kicad_pcb]
2017-10-16 Added initial cutouts for the oval pins
    [rt-soldering-iron.kicad_pcb]
2017-10-16 Changed method for building oval pins for gerber export
    When the gerbers need to be exported, the cutouts should be moved down
    from the user drawing layer. The gerbers should be exported and the
    board revered to the previous state. The gerbers will now be stored in
    the git repository since I've learned it's dumb not to keep a copy of
    those.
    [rt-soldering-iron.kicad_pcb]
2017-10-16 Storing Rev A Gerbers
    [rt-soldering-iron-B.Cu.gbl, rt-soldering-iron-B.Mask.gbs, rt-soldering-iron-B.SilkS.gbo, rt-soldering-iron-Edge.Cuts.gm1, rt-soldering-iron-F.Cu.gtl, rt-soldering-iron-F.Mask.gts, rt-soldering-iron-F.SilkS.gto, rt-soldering-iron.drl]
2017-10-16 Created Rev B Gerbers
    [rt-soldering-iron-B.Cu.gbl, rt-soldering-iron-B.Mask.gbs, rt-soldering-iron-B.SilkS.gbo, rt-soldering-iron-Edge.Cuts.gm1, rt-soldering-iron-F.Cu.gtl, rt-soldering-iron-F.Mask.gts, rt-soldering-iron-F.SilkS.gto, rt-soldering-iron.drl]
2017-10-16 Created gerbv project for viewing the gerbers
2017-10-16 Rebuilt Rev B Gerbers. Fixed shapes around accelerometer.
    [rt-soldering-iron.kicad_pcb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]
2017-11-07 Updated parts for rev B parts order, updated dates
    [analog-frontend.sch, digital-control.sch, power-supplies.sch, rt-soldering-iron.kicad_pcb, rt-soldering-iron.sch]
2017-11-27 Added simulation of the OVP latch circuit
    Turns out, just a static simulation isn't enough. The simulation needs
    to test ramp-up explicitly. Requires that the TL431 model be added (the
    HSPICE model works with LTSpice in this case, surprisingly).
2017-11-27 Fixed a really dumb part number mistake on the comparator
    The comparator part number is ths SOT23 footprint. I had planned for the
    SC-70 footprint. I bought the wrong footprint...
    [analog-frontend.sch]
2018-02-06 Added stm32f031x support package
2018-02-06 Changed shell scripts to a single python script
    The idea is that this will be a little more cross platform. It will also
    be faster for me to implement since I'm far better at Python than bash.
    [flash.cfg]
2018-02-06 Added buzzer initialization as a test
    [main.rs]
2018-02-06 Cleanup after adding flashing method to embedded.py
    [flash.cfg]
2018-02-06 Started adding some enums to the stm32f031x svd
2018-02-06 Made some progress on a structure
    However, I'm pretty sure that this will not work. The storing and
    restoring of the context requires knowledge of the stack frame if I'm to
    do it efficiently.
    [main.rs]
2018-02-06 Changed tasks to start leaning towards an unallocated stack
    The way this is going to work is once the scheduler is initiated, the
    current stack pointer will be noted. All of the configured tasks will
    then have their stacks allocated in the remaining stack space. I've
    decided on this method since syntactically it looks simpler.
    To prevent stack overflow issues, I'd like some way to allocate fake
    space in the linker file for all the stacks to ensure that everything
    fits. Alternatively, I could switch over to the statically allocated
    stack method that FreeRTOS uses.
    [main.rs]
2018-02-06 (WIP) Started writing scheduler and pendsv interrupt
2018-02-06 Fixed PENDSV ISR to actually compile
    Since we are using the main stack pointer always and not switching (for
    now), we can use the standard push and pop instructions. This avoids the
    need for that pesky SUB which I couldn't quite get to compile.
2018-02-06 Added handling for the initial task case
2018-02-06 Fixed test program to buzz the buzzer
    [main.rs]
2018-02-06 Fixed two silly mistakes, a sign switch and a missing mut
    The sign switch resulted in a hard fault. The missing mut probably would
    have also caused a hard fault (since the stack got located in rodata),
    but its fixed now.
2018-02-06 Added a test buzzing program using the new RTOS. It works!!
    [main.rs]
2018-02-06 Added support for adding tasks while the RTOS is running
    This entailed a lot of things that kind of cascaded:
    - First, I needed to add a dedicated idle task outside the array of
    tasks. This way I could ensure the idle task was always the lowest
    priority.
    - That, in turn, meant I needed a way to say that the idle task's stack
    pointer should be stored. The obvious way was to use current_task=None
    to mean that the idle task is running, rather than the RTOS hasn't
    started.
    - Because I no longer had a way to determine if the RTOS had started, I
    needed to find a different way. I decided to implement the msp/psp
    switchover, with the PENDSV interrupt assuming that if it interrupted
    while the proces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
    [main.rs]
2018-02-11 Changed Block trait to no longer use static lifetimes
    This really causes usability problems because any function receiving the
    reference is free to operate directly on the Block forever. We don't
    actually want that. It's like we want to force a static lifetime of the
    reference, but not promise to use it. I don't really know of a good way
    to enforce this, so instead I just made a UniqueId struct based on
    UnsafeCell which creates an atomically incrementing UniqueId.
    [main.rs]
2018-03-04 Added initial PWM abstraction
    There are some things that I really dislike, such as the unsafety in how
    the frequency is changed. I also think that the PwmPin HAL trait isn't
    exactly conducive to Cortex-M0+ CPUs that don't have bitbanding. I
    needed to instantiate a critical section.
    On the bright side, those HAL'd code is only 24 bytes longer than
    non-HAL code.
2018-03-08 Changed alternate functions to be concrete types
    This should allow for using traits to denote that a particular pin in a
    particular alternate function mode can be used in a specific way. It
    also is safer since not all pins implement all alternate functions.
2018-03-31 Initial I2C abstraction implementation using nb
    Note that right now CMD has to be immovable so that the compiler doesn't
    freak about about the Generator referencing something on its own stack
    (self-referential struct). There should be a way to fix this, but I'm
    still reading the docs.
    [i2c.rs, lib.rs, main.rs]
2018-04-01 Added timing information to I2C
    The SSD1306 isn't responding, probably because I haven't enabled the
    pullup on PB3. I need to restructure the GPIO HAL a bit.
2018-04-08 Fixed various bugs relating to timing
    [i2c.rs, main.rs, pwm.rs, rcc.rs]
2018-04-08 Added separate board support crate and systick wrapper
    The systick wrapper now allows for some non-deterministic timing to
    occur (i.e. 'wait roughly 1/2 second').
2018-04-12 Changed I2C implementation to eliminate data borrows
2018-04-13 Changed I2C write state machine to use tokens
    Rather than having to pass in dummy data, the poll function is now truly
    idempotent, returning only a token that can be used to advance the
    write.
2018-04-30 Created a static slice writer in the I2C peripheral
2018-05-01 Fixed some truncation bugs in the hline and vline methods
    Apparently C coerces these to be larger
    [main.rs, ssd1306.rs]
2018-05-08 Added basic bitmap and font rendering capabilities
    Currently, I only have an 8x8 IBM font. I need to get a 16x16 font for
    the numbers and I'll be golden.
2018-05-08 Fixed main to build after gfx cleanup
    [main.rs]
2018-05-08 Added test and fixed a couple problems with the mutex
    Now, it's not a very good test. If the locking logic is wrong we'll have
    a problem. However, this is going to be used really only for display and
    UI communication with the main heater control loop, so it isn't critical
    if it is out of sync occasionally.
    [lib.rs, main.rs]
2018-05-09 Changed main to use string slices and fixed font to match on char
    [font.rs, main.rs]
2018-05-09 Added initial single-shot ADC implementation
    I haven't confirmed that it works yet...
2018-05-09 Started building a continuous conversion framework
2018-05-10 Fixed AdcValue conversions and hex function
    [adc.rs, main.rs]
2018-05-10 Cleaning warnings from ADC
2018-05-10 Moved SSD1306 reset into the SSD1306 component
    [main.rs, ssd1306.rs]
2018-05-10 Removed all C firmware
    The rust firmware is now in more or less the same place as the C
    firmware.
    [flash.cfg]
2018-05-19 Fixed PWM to handle both TIM1 and TIM14
    [pwm.rs]
2018-05-19 First try at PID with general Process trait (does not compile)
2018-05-19 Got less ambitious and made PID operate directly on a PwmPin
2018-05-28 Fixed PID to handle maximum and minimum duty cycle values
    The max duty is not the max of u16
    [main.rs, pid.rs]
2018-05-28 Changed PID to use some fixed point arithmetic
    [main.rs, pid.rs]
2018-06-03 Added note with conversion and amplification factors to schematic
    [analog-frontend.sch]
2018-06-03 Added ADC conversion and display that assumes 3V=500C
2018-06-09 Increased integral factor of PID so we get to 100% duty cycle
2018-06-30 Fixed SysTick to be declared
    I had to add the `rt` crate to board-support so that I could get the
    exception! macro. I guess the interrupt! and exception! macros actually
    define the function, so it gets to be `pub use`d back up at main.
    The program now runs without hard faults. So difficult to figure out
    what was wrong...
    [buzzer.rs, lib.rs, main.rs, systick.rs]
